gtetil/ME21000-Swoish-Grain-Control/Spec Sheets/chute control panel 9-5-2021.pdf

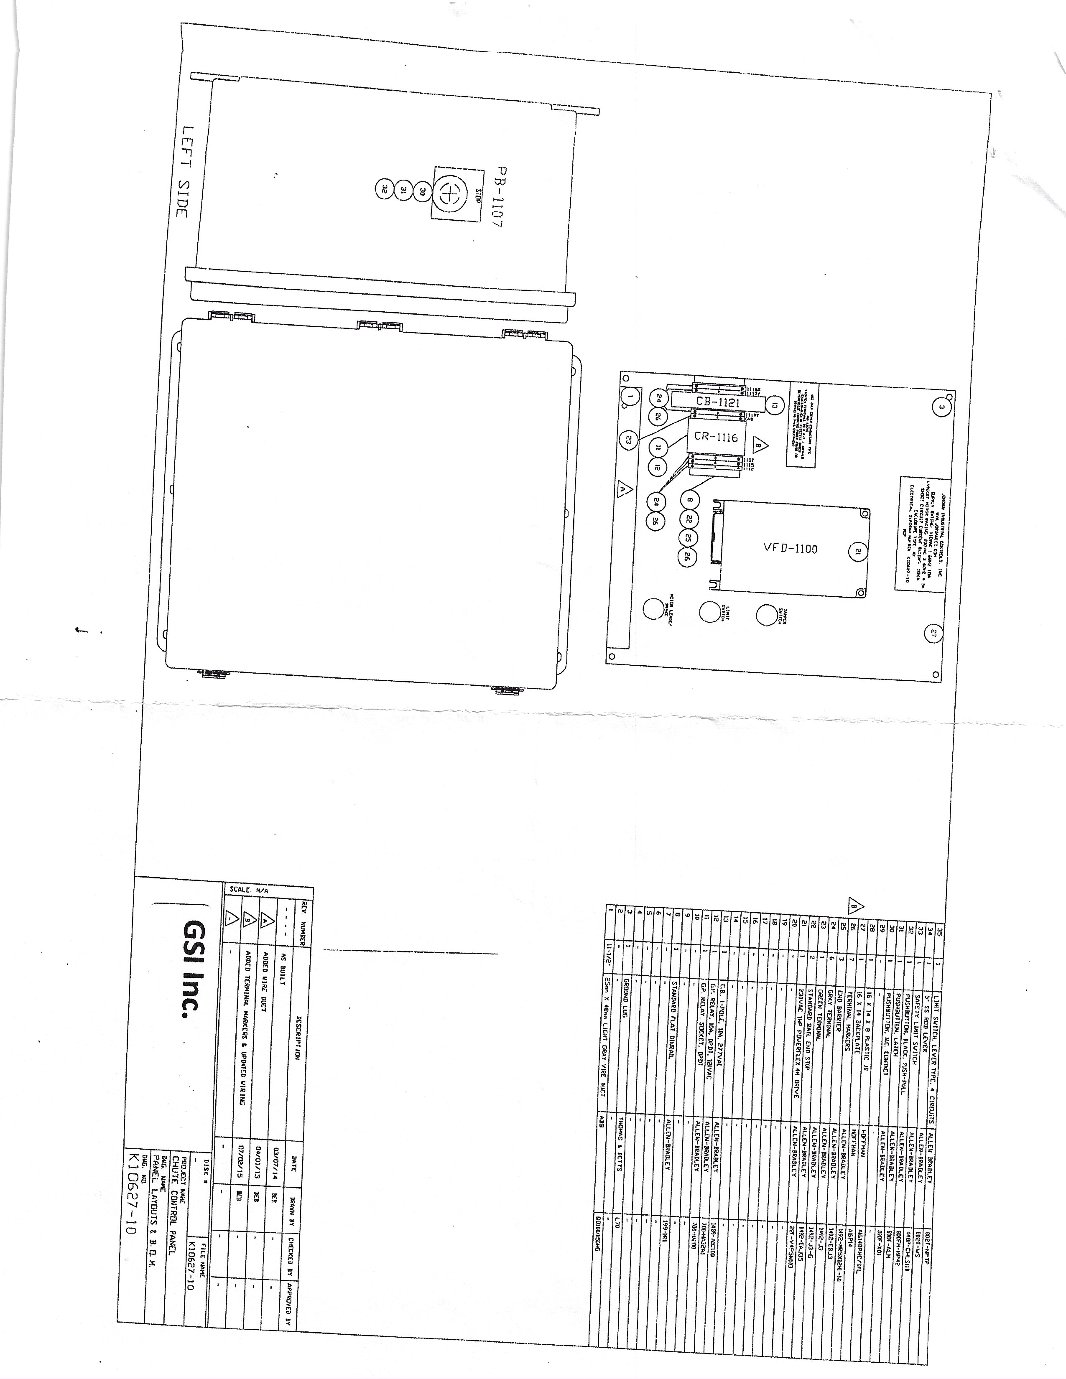
[picture p1: page 1]
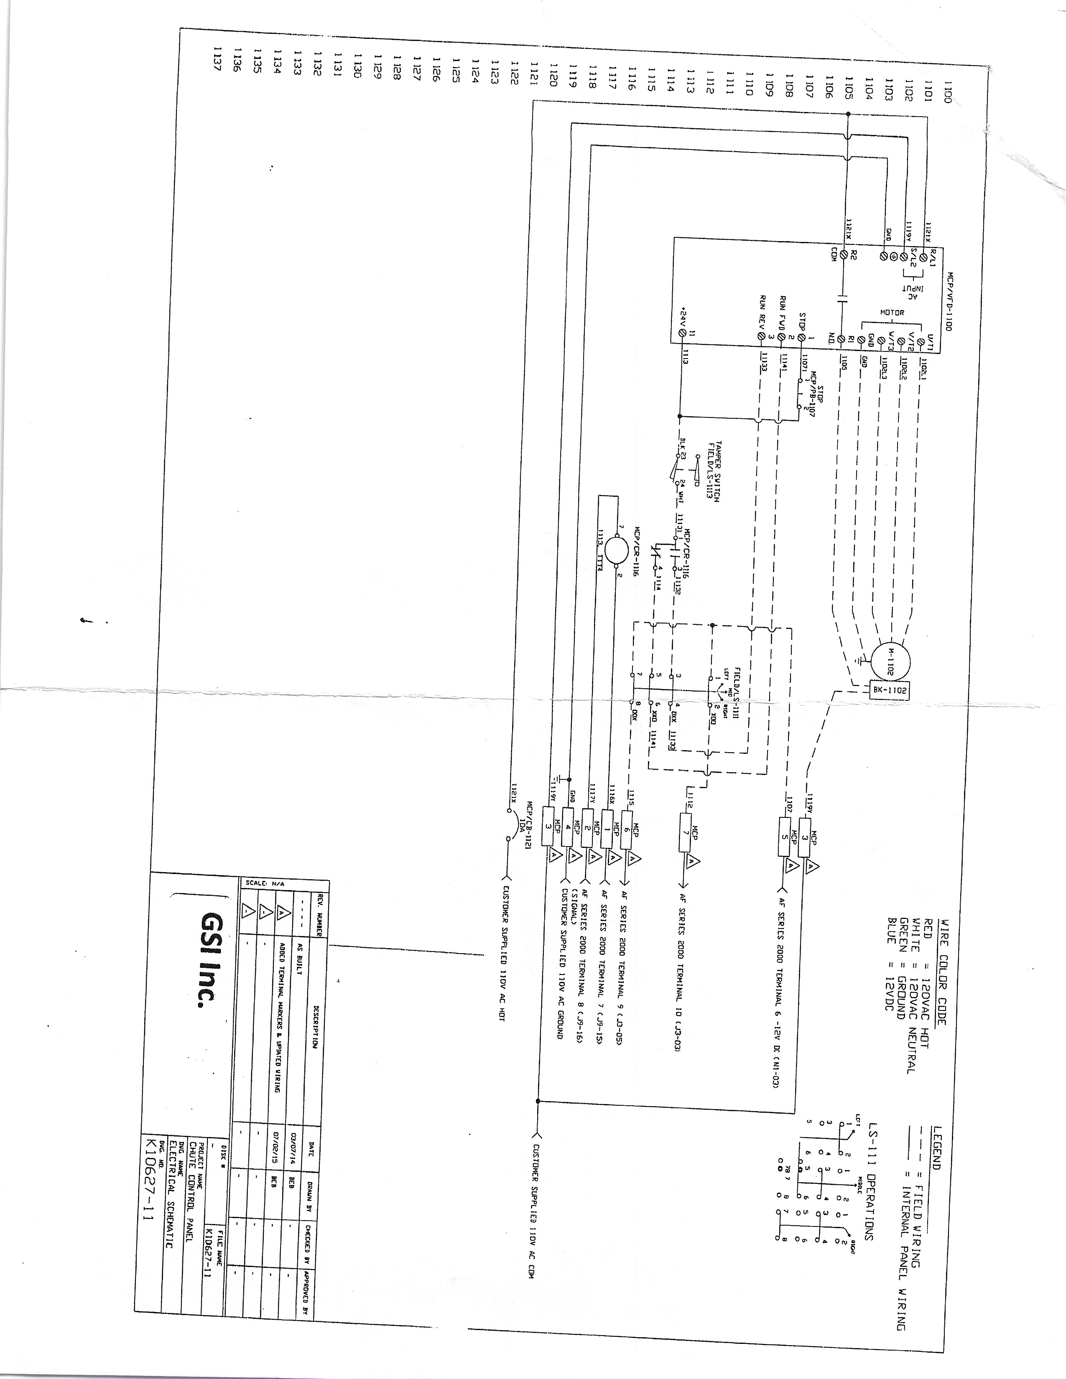
[picture p2: page 2]
