gtetil/ME21000-Swoish-Grain-Control/Electrical/ME21000E02-Model.png

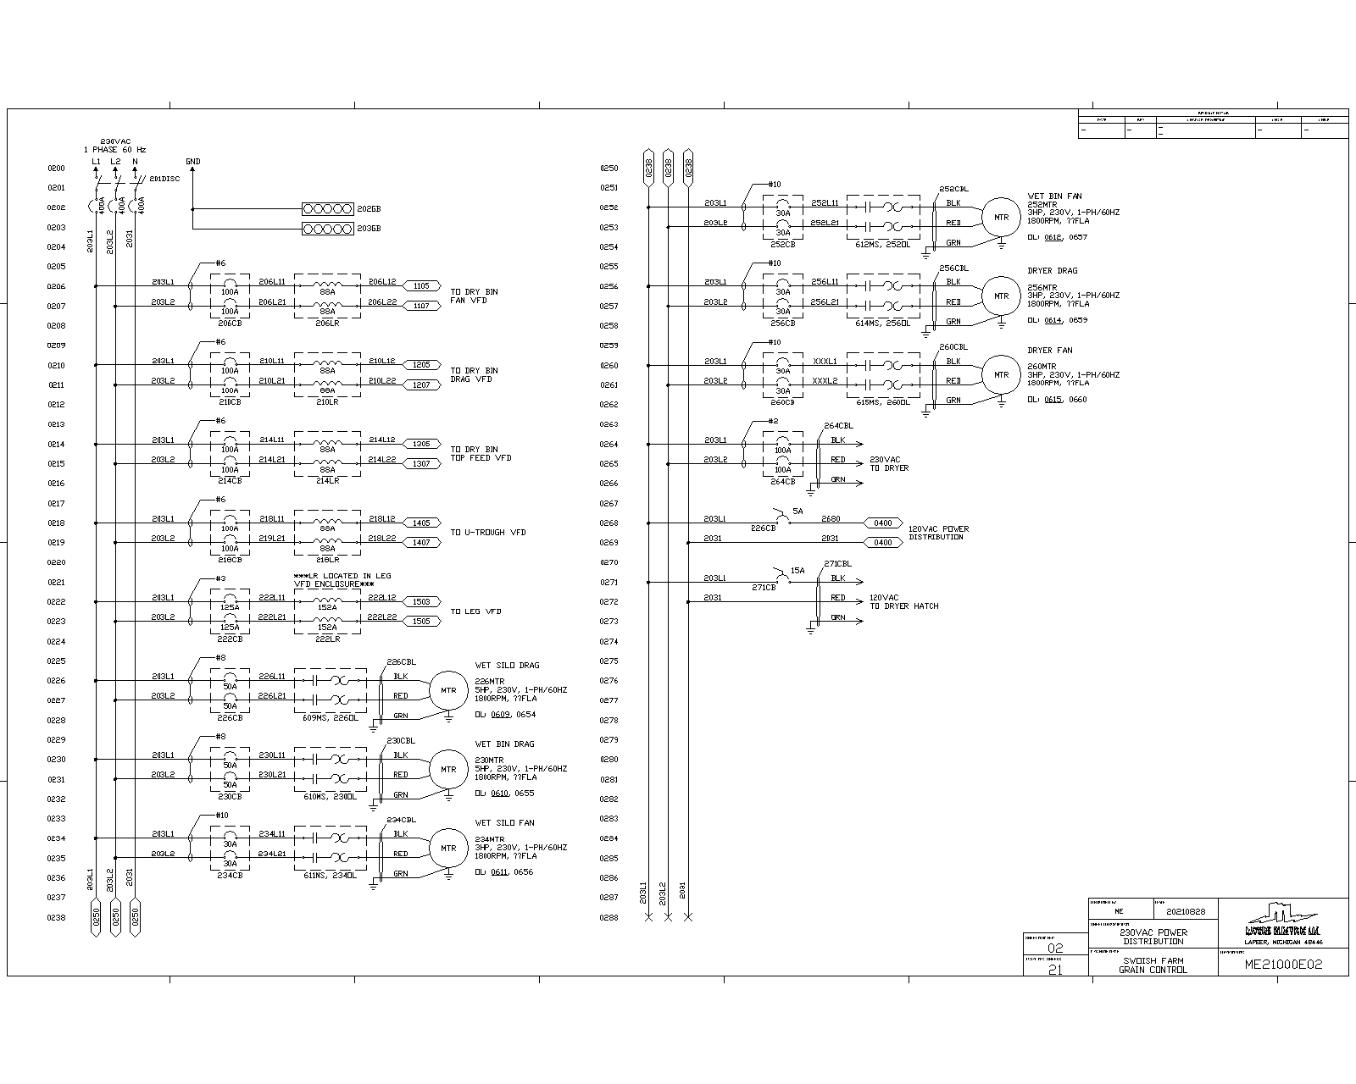
Electrical/ME21000E02-Model.png
