gtetil/ME21000-Swoish-Grain-Control/(list of files, cad)

Other CAD files:
LabVIEW/Layout/Grain Operation Layout.dwg
Electrical/ME21000E20.dwg
Electrical/ME21000E18.dwg
Electrical/ME21000E13.dwg
Electrical/ME21000E00.dwg
Electrical/ME21000E23.dwg
Electrical/ME21000E14.dwg
Electrical/ME21000E22.dwg
Electrical/ME21000E19.dwg
Electrical/ME21000E09.dwg
Electrical/ME21000E06.dwg
Electrical/ME21000E04.dwg
Electrical/ME21000E02.dwg
Electrical/ME21000E08.dwg
Electrical/ME21000E03.dwg
Electrical/ME21000E21.dwg
Electrical/ME21000E05.dwg
Electrical/ME21000E12.dwg
