gtetil/ME21000-Swoish-Grain-Control/Electrical/Swoish Grain Control BOM.pdf

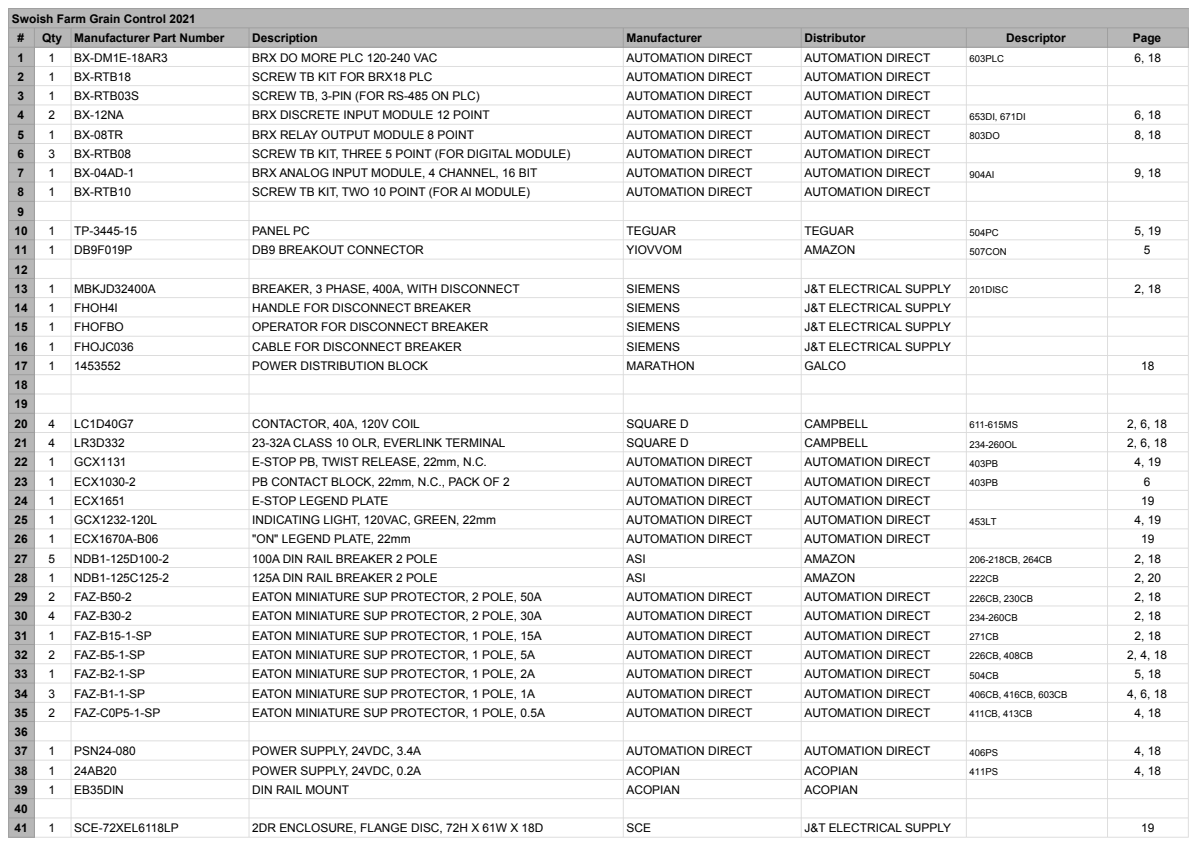
[picture p4: page 1]
Swoish Farm Grain Control 2021; Qty Manufacturer Part Number; Description; Manufacturer; Distributor; Descriptor; Page; BRX DO MORE PLC 120-240 VAC; AUTOMATION DIRECT; 603PLC; BX-RTB18; SCREW TB KIT FOR BRX18 PLC; BX-RTB03S; SCREW TB, 3-PIN (FOR RS-485 ON PLC); BRX DISCRETE INPUT MODULE 12 POINT; BRX RELAY OUTPUT MODULE 8 POINT; BX-RTB08; SCREW TB KIT, THREE 5 POINT (FOR DIGITAL MODULE); BRX ANALOG INPUT MODULE, 4 CHANNEL, 16 BIT; BX-RTB10; SCREW TB KIT, TWO 10 POINT (FOR AI MODULE); PANEL PC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

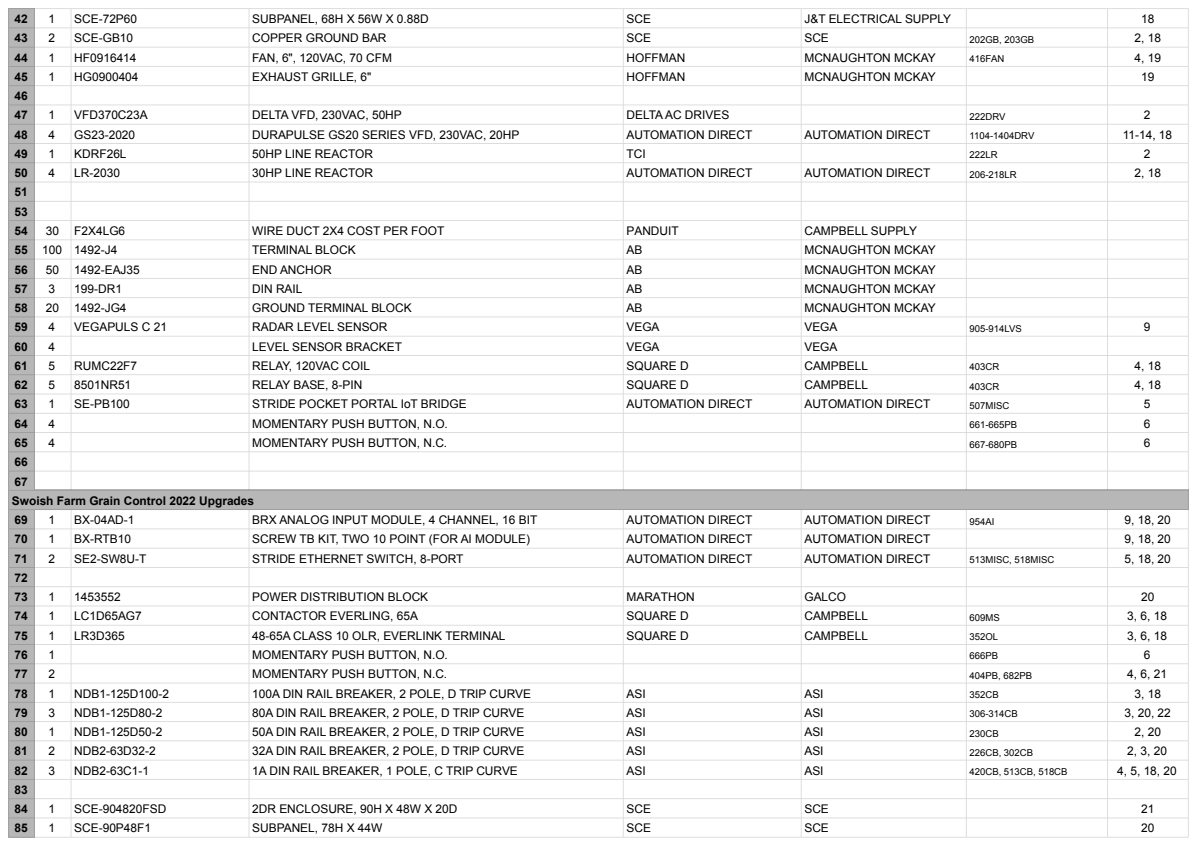
[picture p5: page 2]
SCE-72P60; SUBPANEL, 68H X 56W X 0.88D; SCE; J&T ELECTRICAL SUPPLY; SCE-GB10; COPPER GROUND BAR; FAN, 6", 120VAC, 70 CFM; HOFFMAN; MCNAUGHTON MCKAY; 416FAN; EXHAUST GRILLE, 6"; VFD370C23A; DELTA VFD, 230VAC, 50HP; DELTA AC DRIVES; 222DRV; DURAPULSE GS20 SERIES VFD, 230VAC, 20HP; AUTOMATION DIRECT; 1104-1404DRV; KDRF26L; 50HP LINE REACTOR; TCI; 30HP LINE REACTOR; WIRE DUCT 2X4 COST PER FOOT; PANDUIT; CAMPBELL SUPPLY; TERMINAL BLOCK; 1492-EAJ35; END ANCHOR; DIN RAIL; GROUND TERMINAL BLOCK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

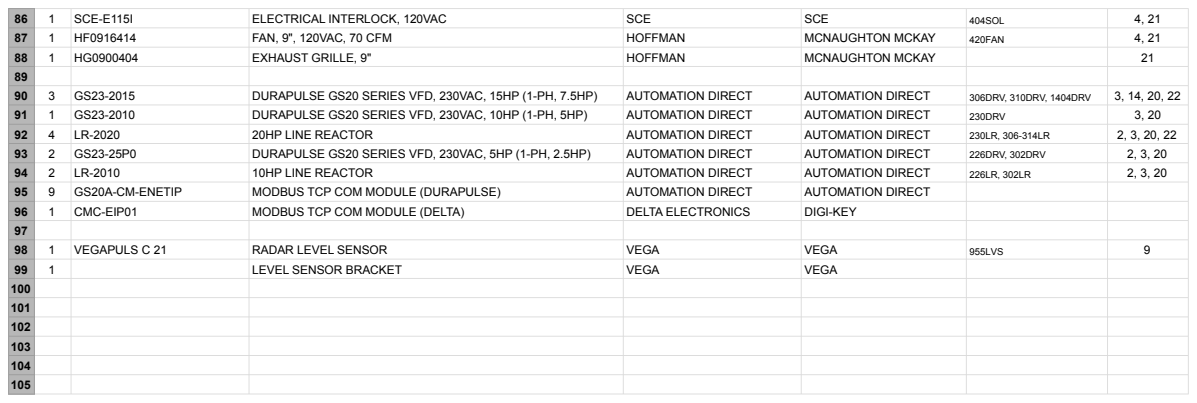
[picture p6: page 3]
SCE-E115I; ELECTRICAL INTERLOCK, 120VAC; SCE; 404SOL; FAN, 9", 120VAC, 70 CFM; HOFFMAN; MCNAUGHTON MCKAY; 420FAN; EXHAUST GRILLE, 9"; DURAPULSE GS20 SERIES VFD, 230VAC, 15HP (1-PH, 7.5HP); AUTOMATION DIRECT; 306DRV, 310DRV, 1404DRV; DURAPULSE GS20 SERIES VFD, 230VAC, 10HP (1-PH, 5HP); 230DRV; 20HP LINE REACTOR; DURAPULSE GS20 SERIES VFD, 230VAC, 5HP (1-PH, 2.5HP); 226DRV, 302DRV; 10HP LINE REACTOR; GS20A-CM-ENETIP; MODBUS TCP COM MODULE (DURAPULSE); CMC-EIP01; MODBUS TCP COM MODULE (DELTA)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
