gtetil/ME21000-Swoish-Grain-Control/Electrical/Swoish Grain Control BOM (2021).pdf

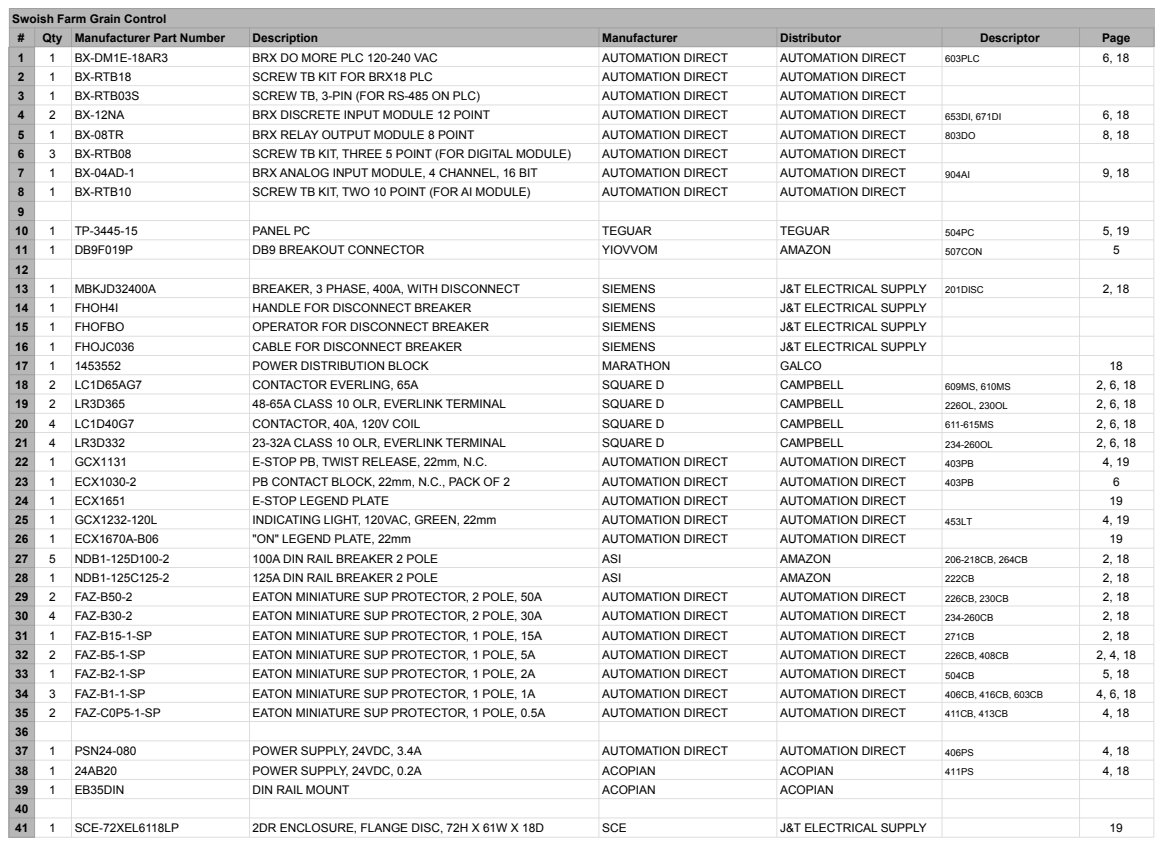
[picture p7: page 1]
Swoish Farm Grain Control; Qty; Manufacturer Part Number; Description; Manufacturer; Distributor; Descriptor; Page; BRX DO MORE PLC 120-240 VAC; AUTOMATION DIRECT; 603PLC; BX-RTB18; SCREW TB KIT FOR BRX18 PLC; BX-RTB03S; SCREW TB, 3-PIN (FOR RS-485 ON PLC); BRX DISCRETE INPUT MODULE 12 POINT; BRX RELAY OUTPUT MODULE 8 POINT; BX-RTB08; SCREW TB KIT, THREE 5 POINT (FOR DIGITAL MODULE); BRX ANALOG INPUT MODULE, 4 CHANNEL, 16 BIT; BX-RTB10; SCREW TB KIT, TWO 10 POINT (FOR AI MODULE); PANEL PC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

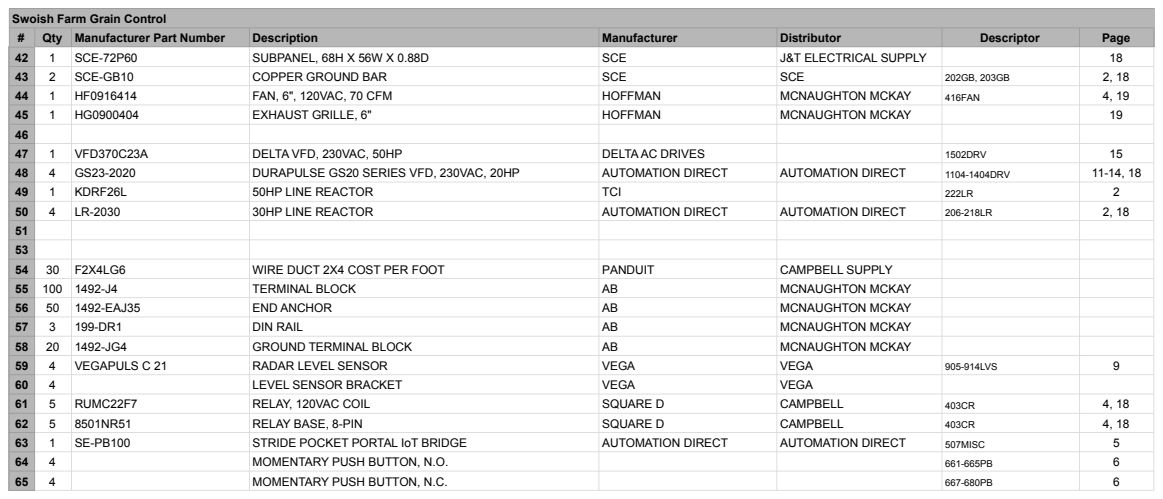
[picture p8: page 2]
Swoish Farm Grain Control; Qty; Manufacturer Part Number; Description; Manufacturer; Distributor; Descriptor; Page; SCE-72P60; SUBPANEL, 68H X 56W X 0.88D; SCE; J&T ELECTRICAL SUPPLY; SCE-GB10; COPPER GROUND BAR; FAN, 6", 120VAC, 70 CFM; HOFFMAN; MCNAUGHTON MCKAY; 416FAN; EXHAUST GRILLE, 6"; VFD370C23A; DELTA VFD, 230VAC, 50HP; DELTA AC DRIVES; 1502DRV; DURAPULSE GS20 SERIES VFD, 230VAC, 20HP; AUTOMATION DIRECT; 1104-1404DRV; KDRF26L; 50HP LINE REACTOR; TCI; 30HP LINE REACTOR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
