gtetil/ME21000-Swoish-Grain-Control/Electrical/ME21000 Swoish Grain Control.pdf

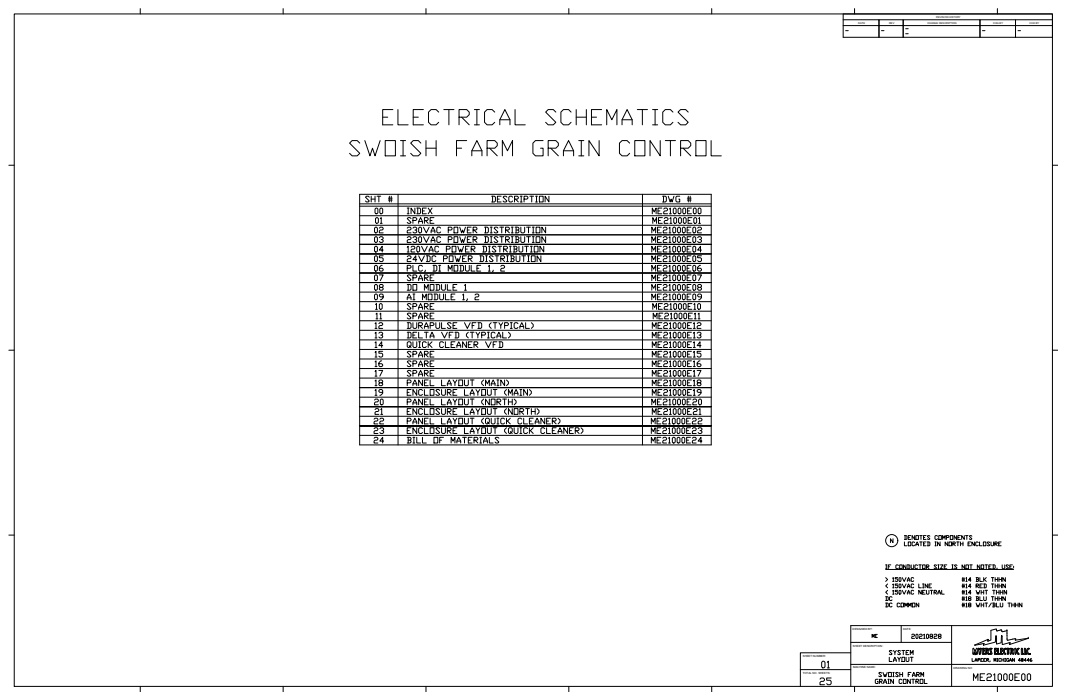
[picture p9: page 1]
MACHINE NAME:; DRAWING NO: DESIGNED BY: SHEET NUMBER: TOTAL NO. SHEETS:; SHEET DESCRIPTION:; DATE:; REVISION HISTORY DATE; REV; CHANGE DESCRIPTION; CHG BY; CHK BY

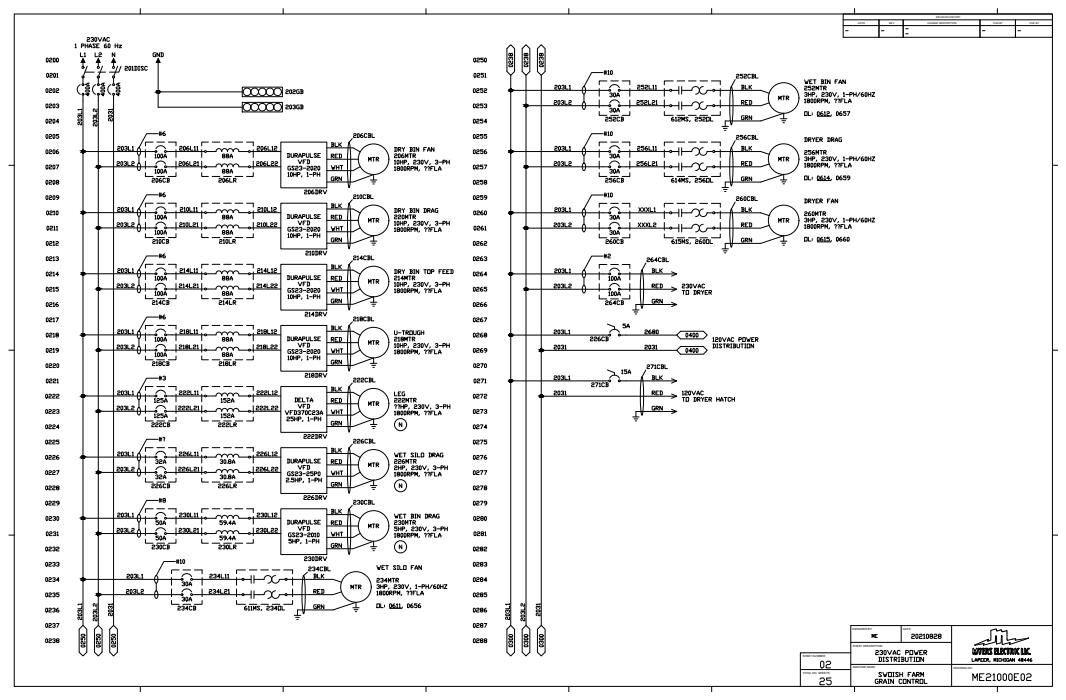
[picture p10: page 2]
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

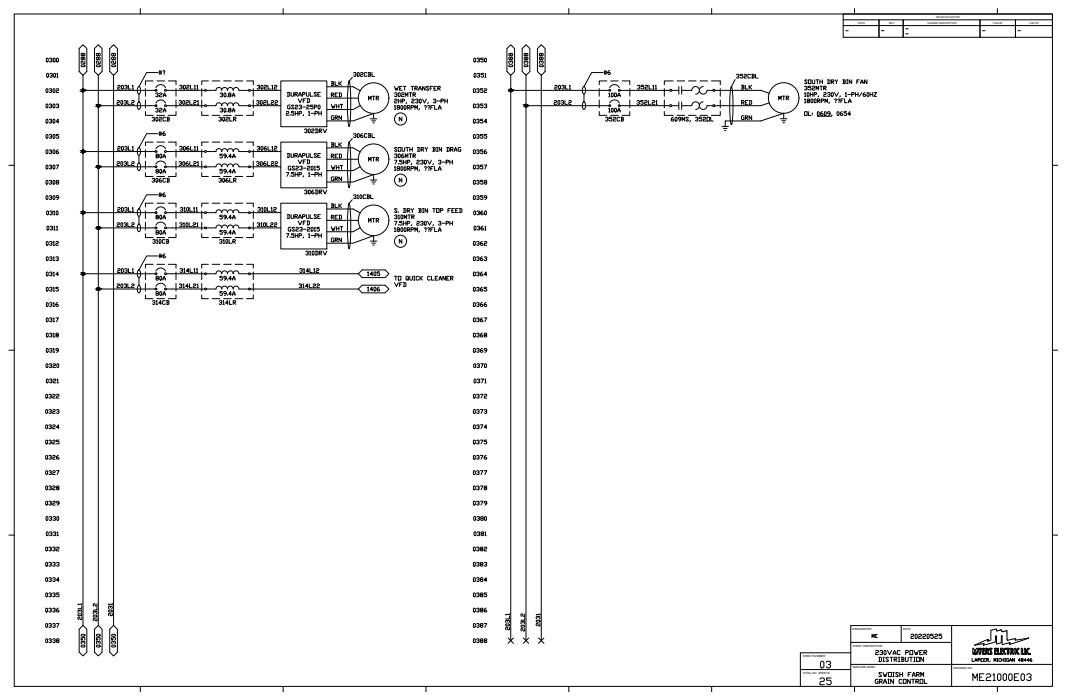
[picture p11: page 3]
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

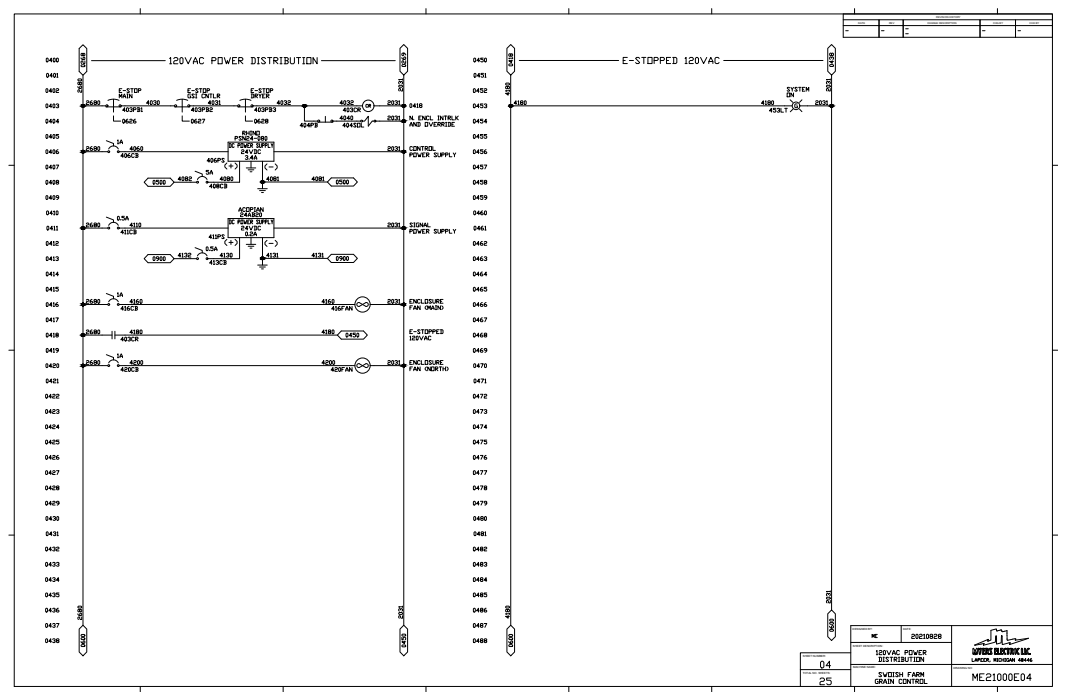
[picture p12: page 4]
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

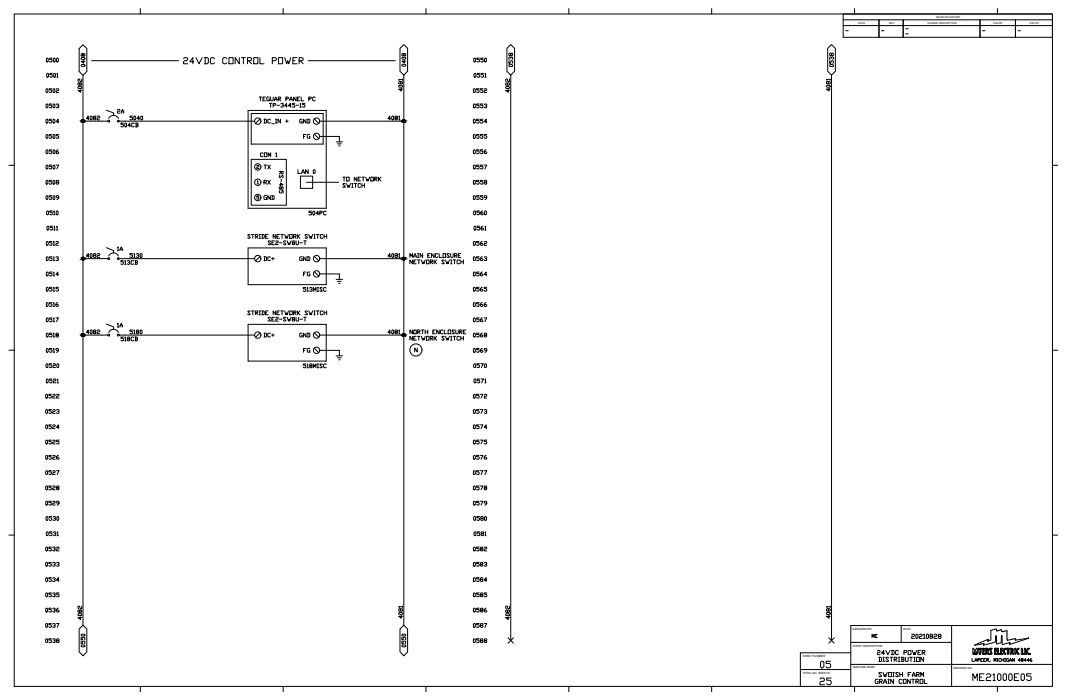
[picture p13: page 5]
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

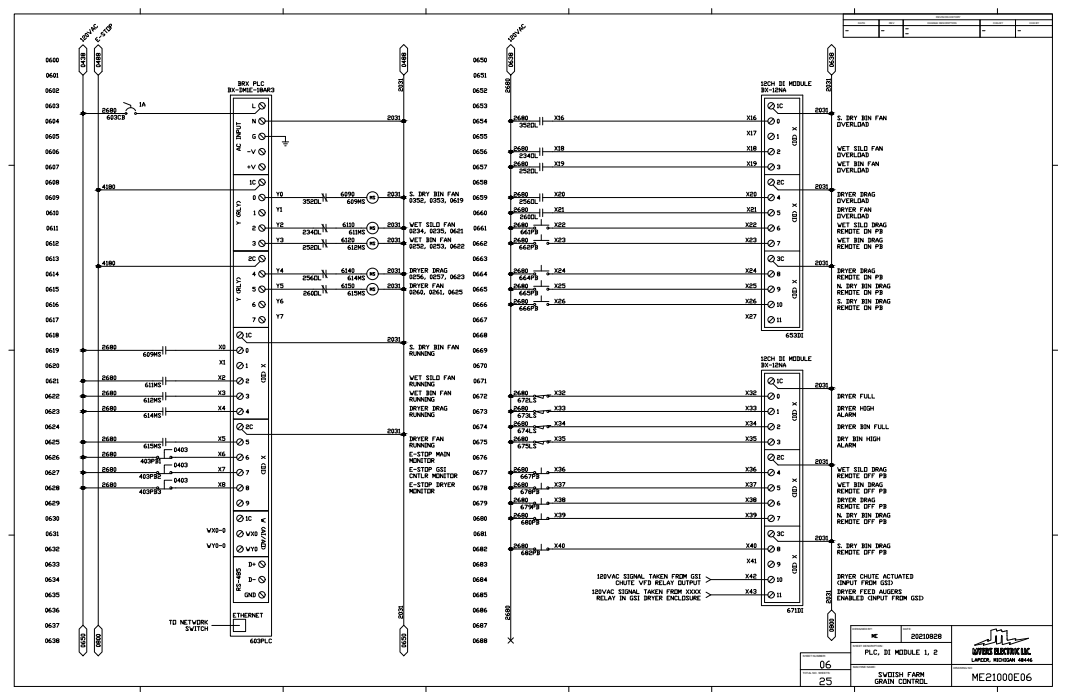
[picture p14: page 6]
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

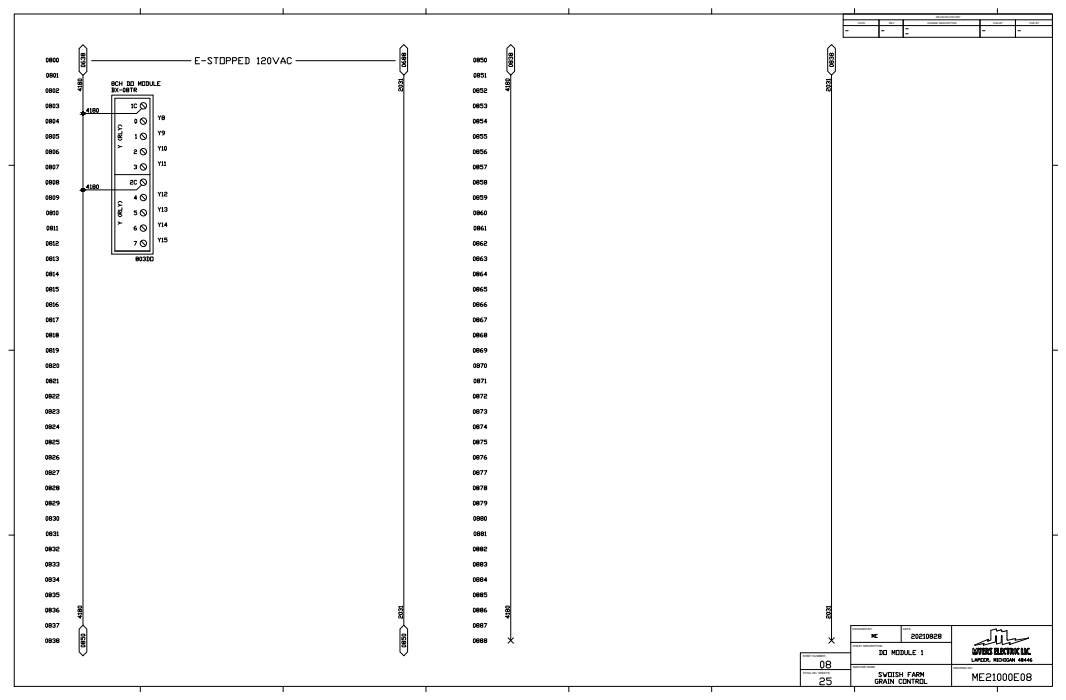
[picture p15: page 7]
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

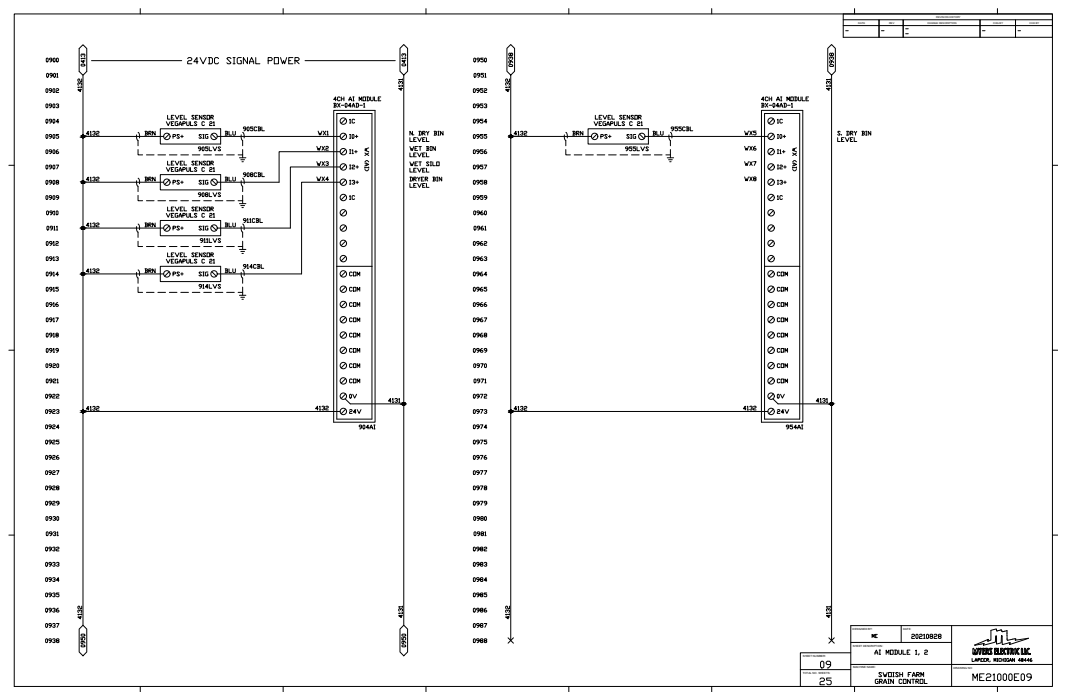
[picture p16: page 8]
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

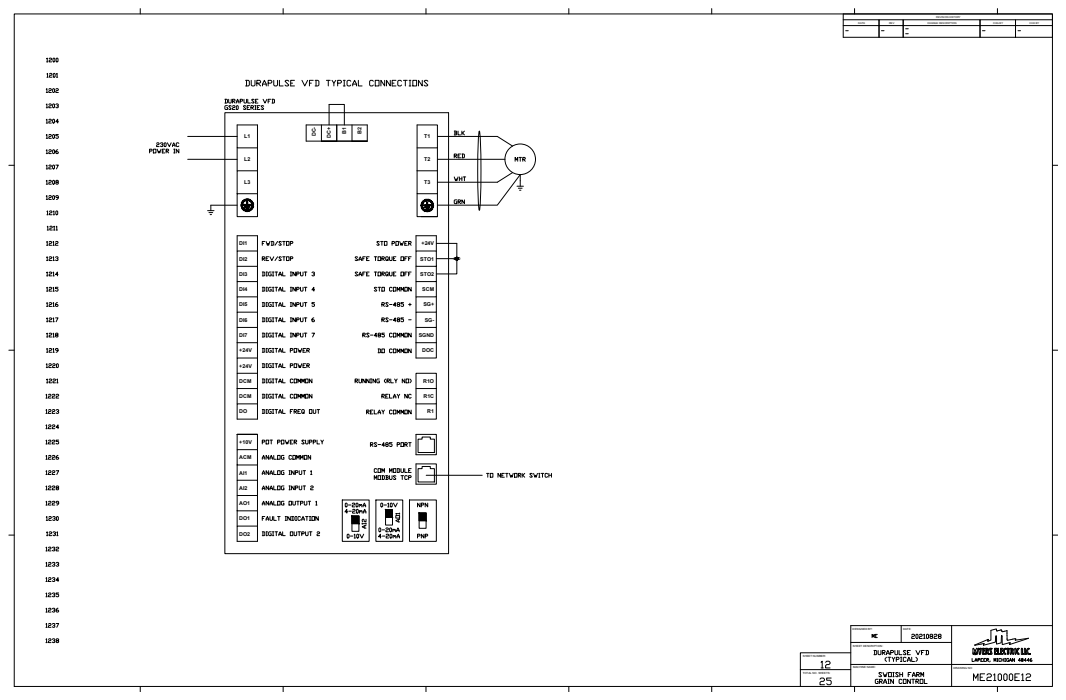
[picture p17: page 9]
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

DC+B1 B2 +24V +24V DI1 DI2 DI3 DI4 DI5 DI6 DI7 DCM DODCM AI1 AI2 +10V ACM DO1 DO2 AO1 +24V STO1 STO2 SCM SG+ SG- SGND DOC R1O R1CR1 T1T2T3

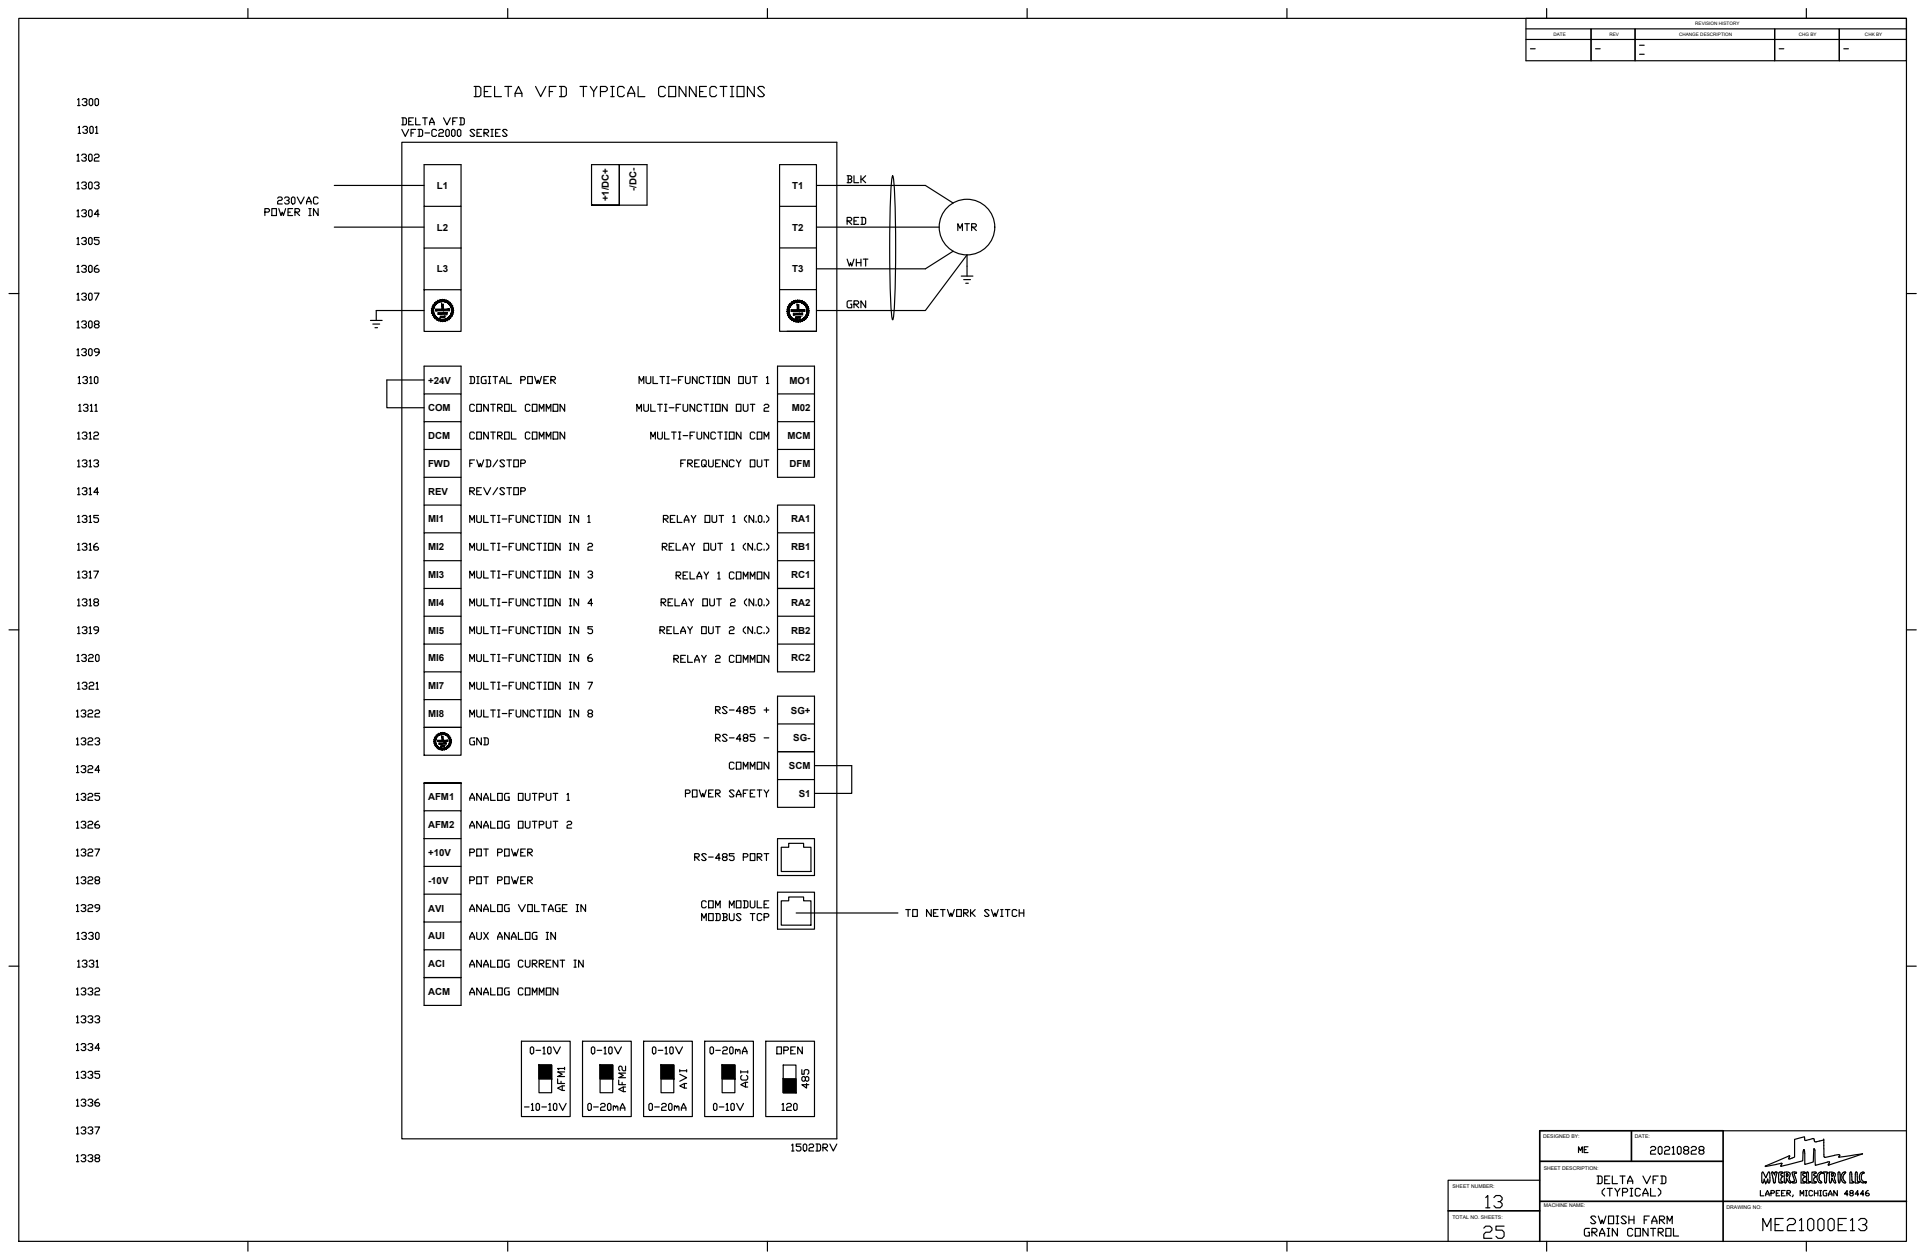
[picture p18: page 10]
MACHINE NAME:; DRAWING NO: DESIGNED BY: SHEET NUMBER: TOTAL NO. SHEETS:; SHEET DESCRIPTION:; DATE:; REVISION HISTORY DATE; REV; CHANGE DESCRIPTION; CHG BY; CHK BY L1L2L3

-/DC- MI3 MI4 +24V COM DCM FWD REV MI1 MI2 MI6 MI7 MI5 +10V -10V AFM1 AFM2 AUI ACI AVI MO1 M02 MCM DFM RA1 RB1 RC1 T1T2T3 ACM SG+ SG- RA2 RB2 RC2 SCMS1 MI8

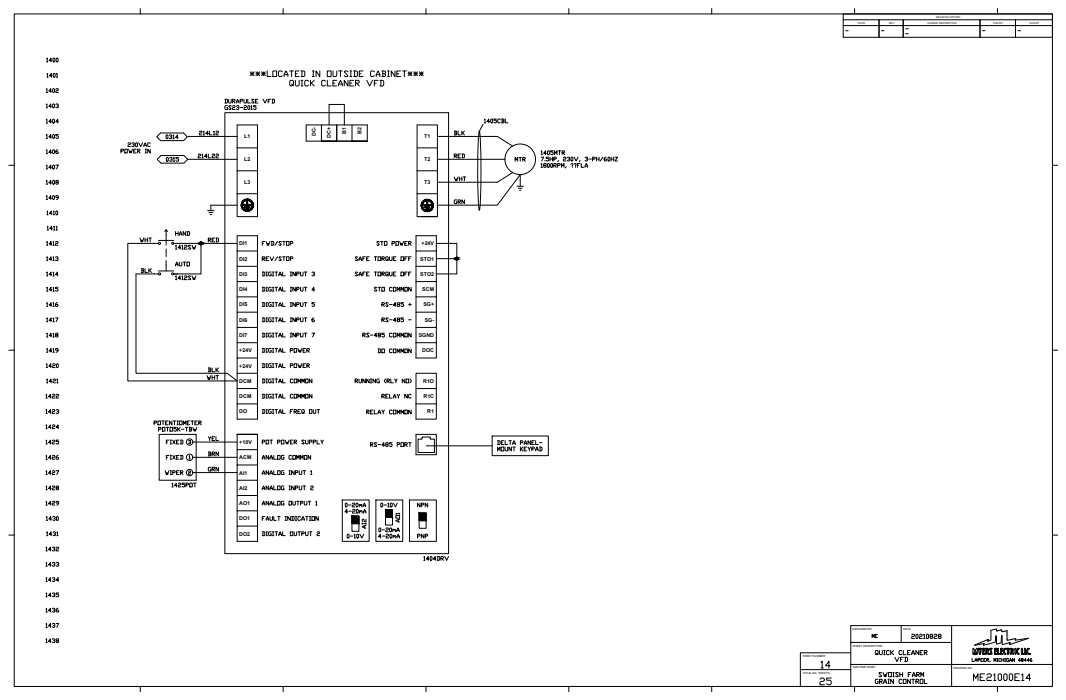
[picture p19: page 11]
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

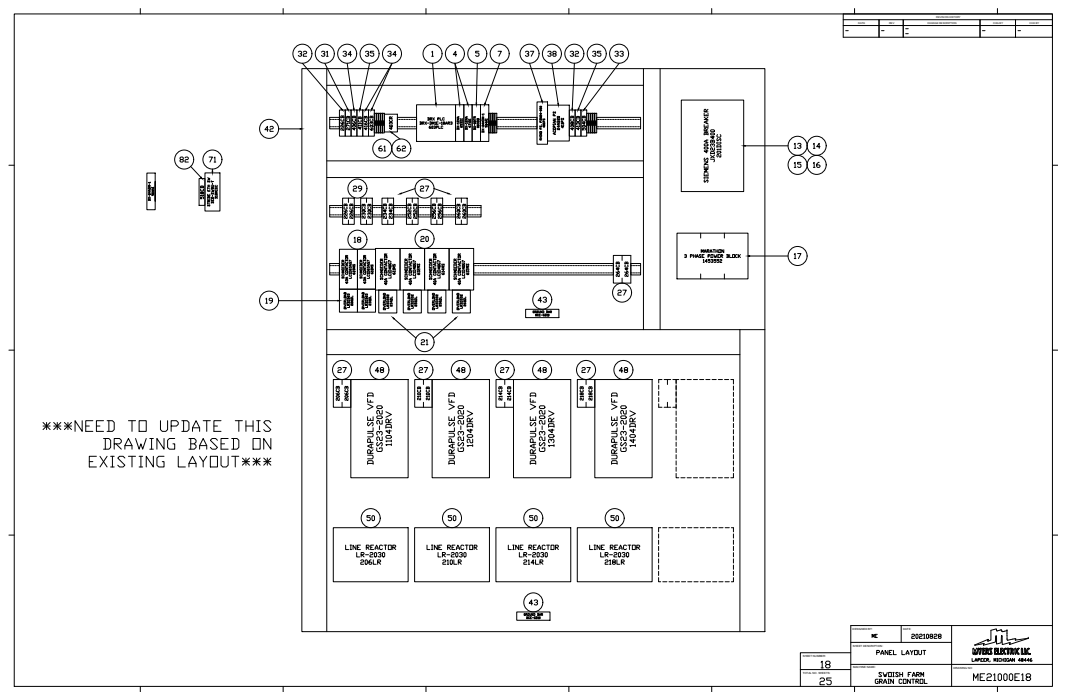
[picture p20: page 12]
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

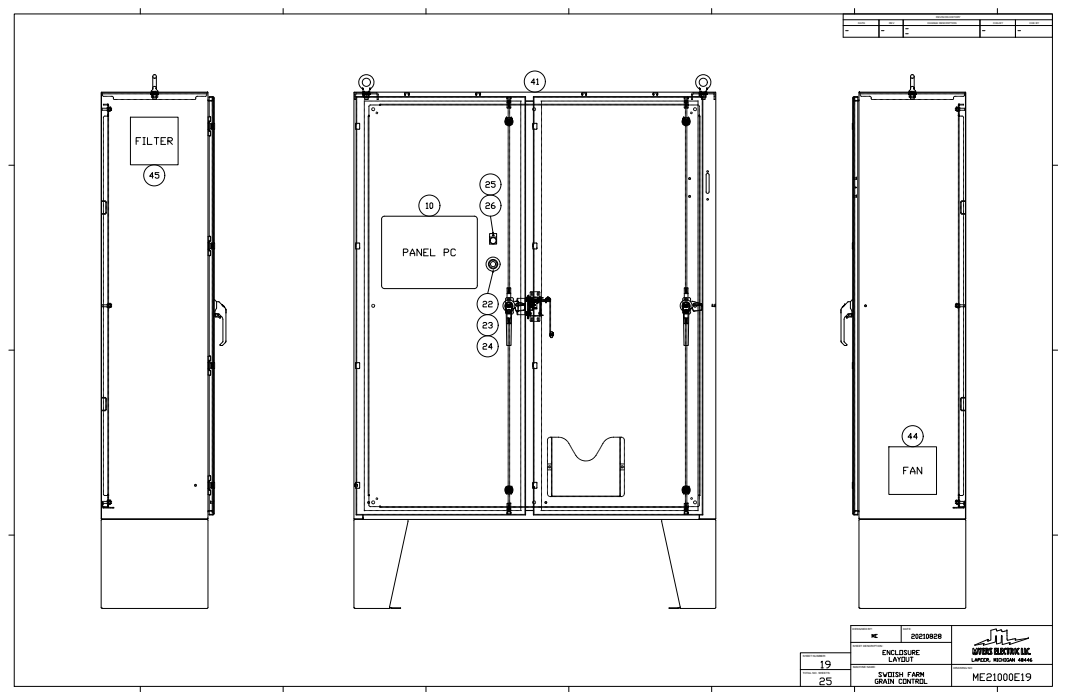
[picture p21: page 13]
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

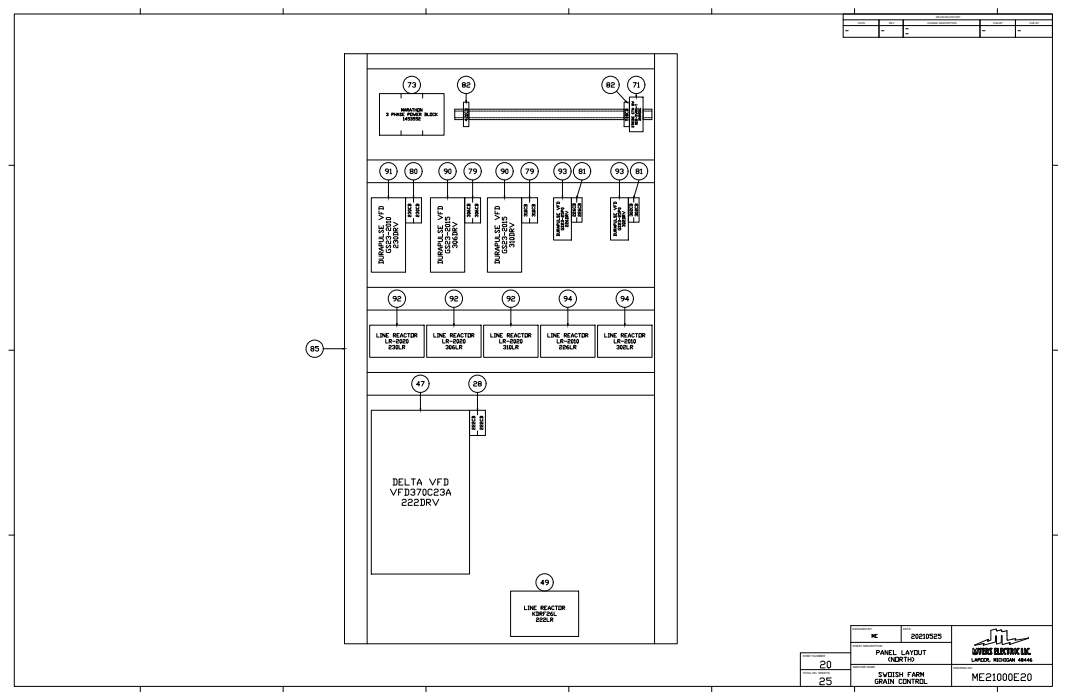
[picture p22: page 14]
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

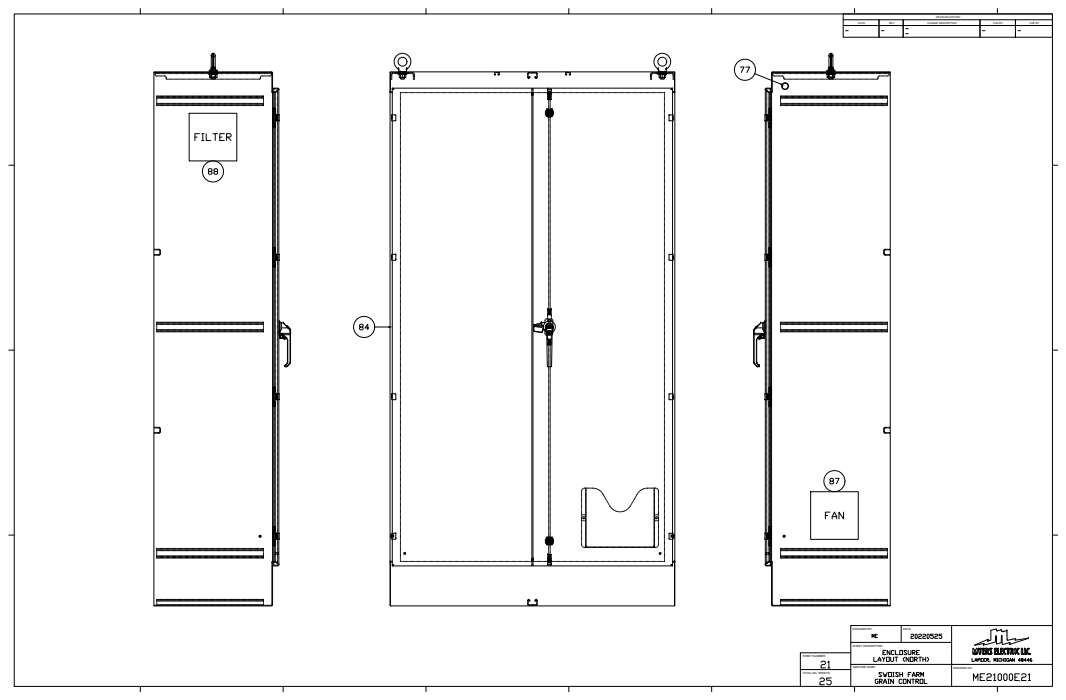
[picture p23: page 15]
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

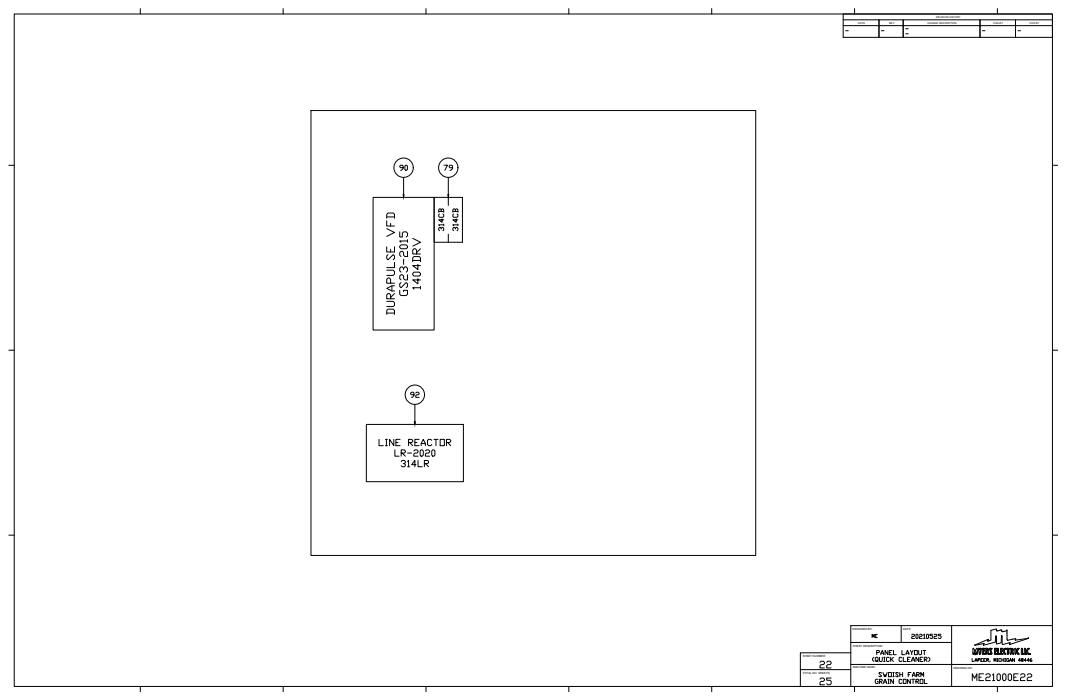
[picture p24: page 16]
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

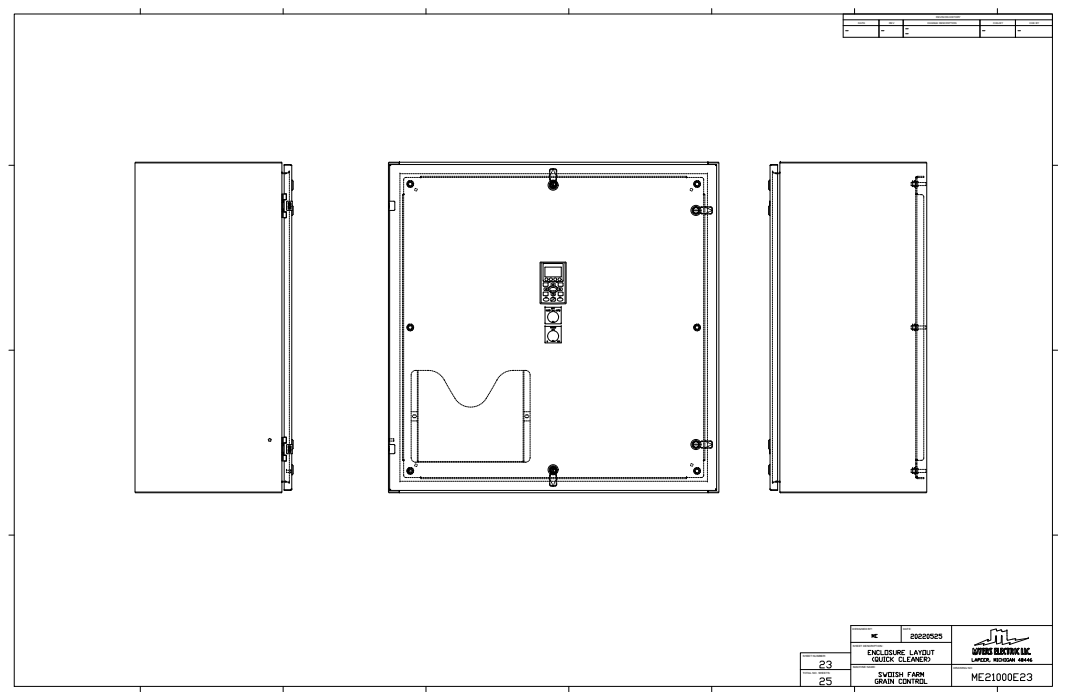
[picture p25: page 17]
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
