gtetil/ME21000-Swoish-Grain-Control/Electrical/ME21000 Swoish Grain Control (2021).pdf

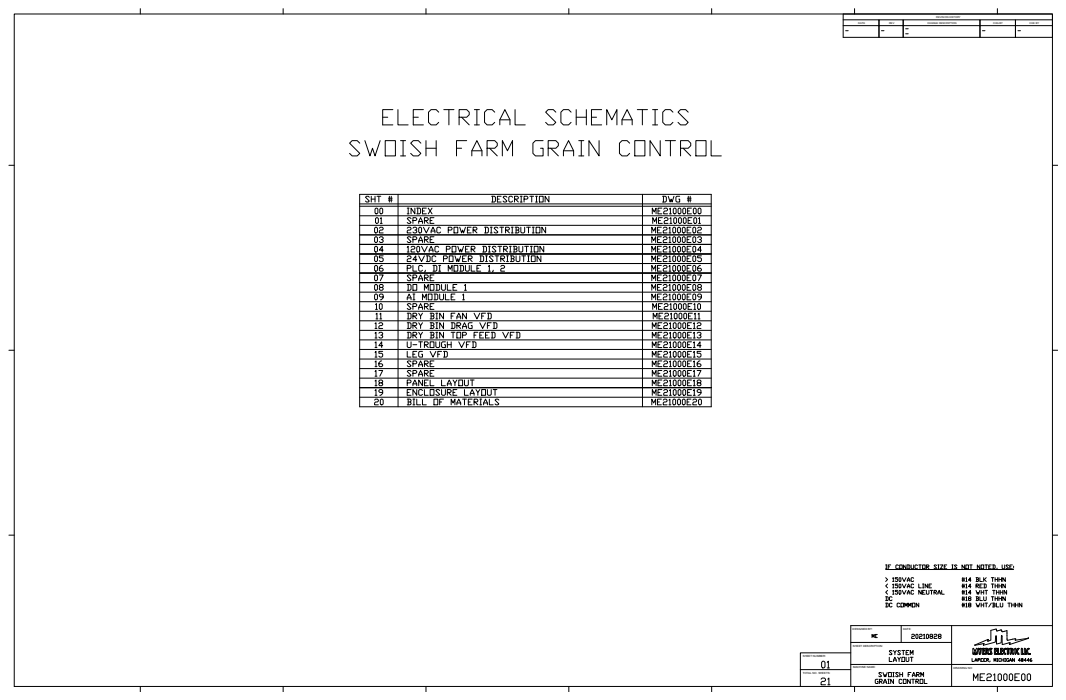
[picture p26: page 1]
MACHINE NAME:; DRAWING NO: DESIGNED BY: SHEET NUMBER: TOTAL NO. SHEETS:; SHEET DESCRIPTION:; DATE:; REVISION HISTORY DATE; REV; CHANGE DESCRIPTION; CHG BY; CHK BY

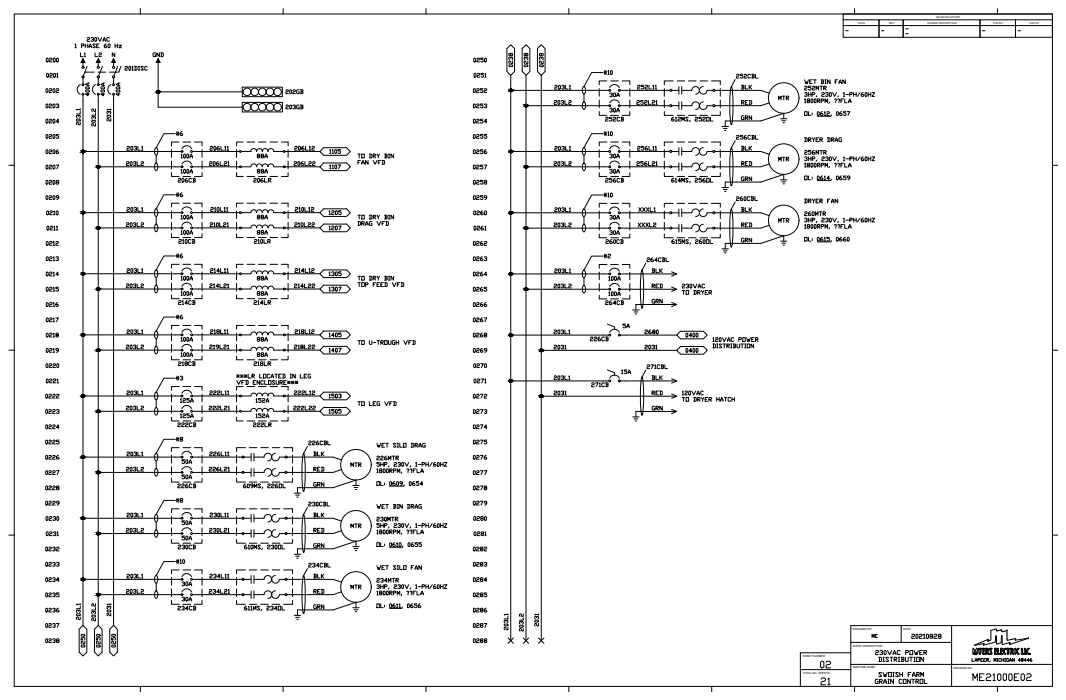
[picture p27: page 2]
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

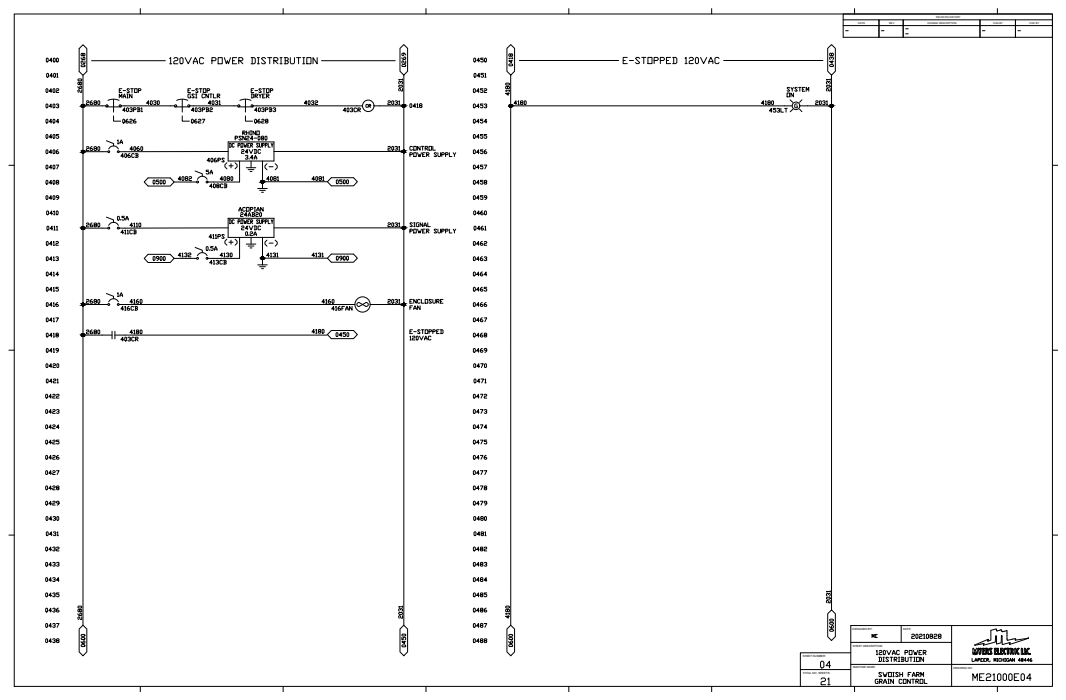
[picture p28: page 3]
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

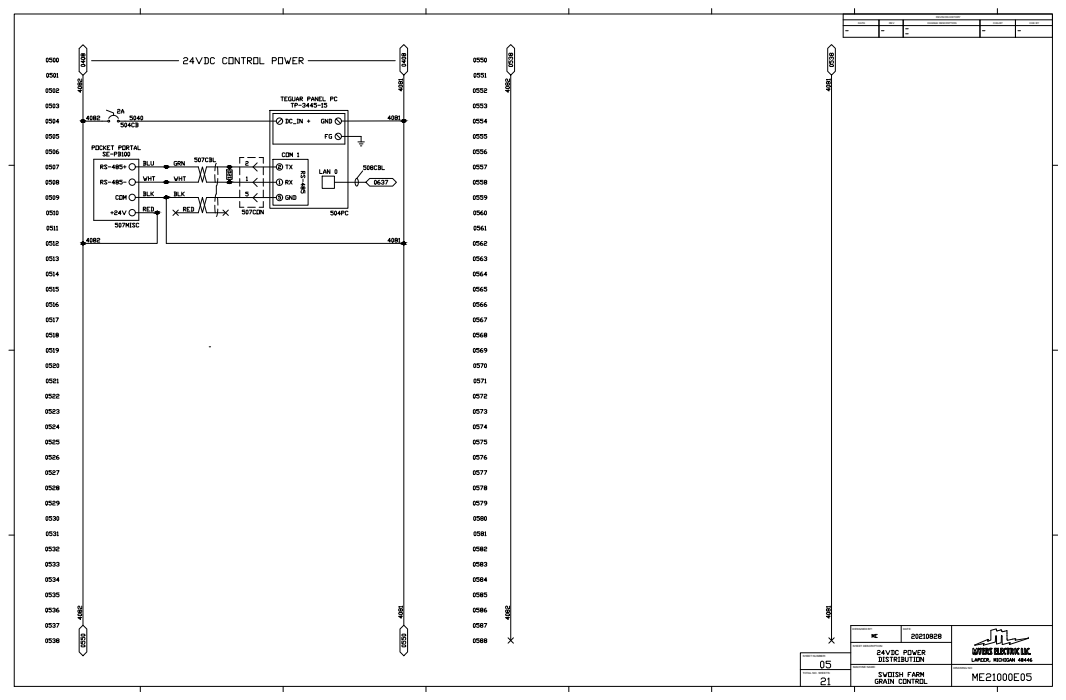
[picture p29: page 4]
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

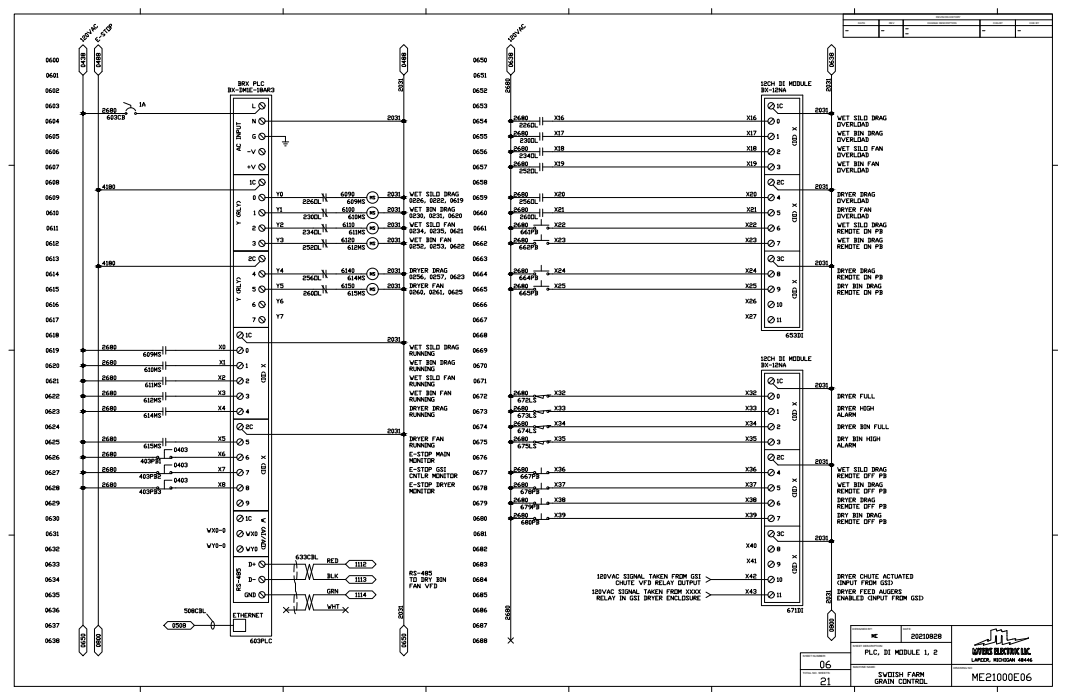
[picture p30: page 5]
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

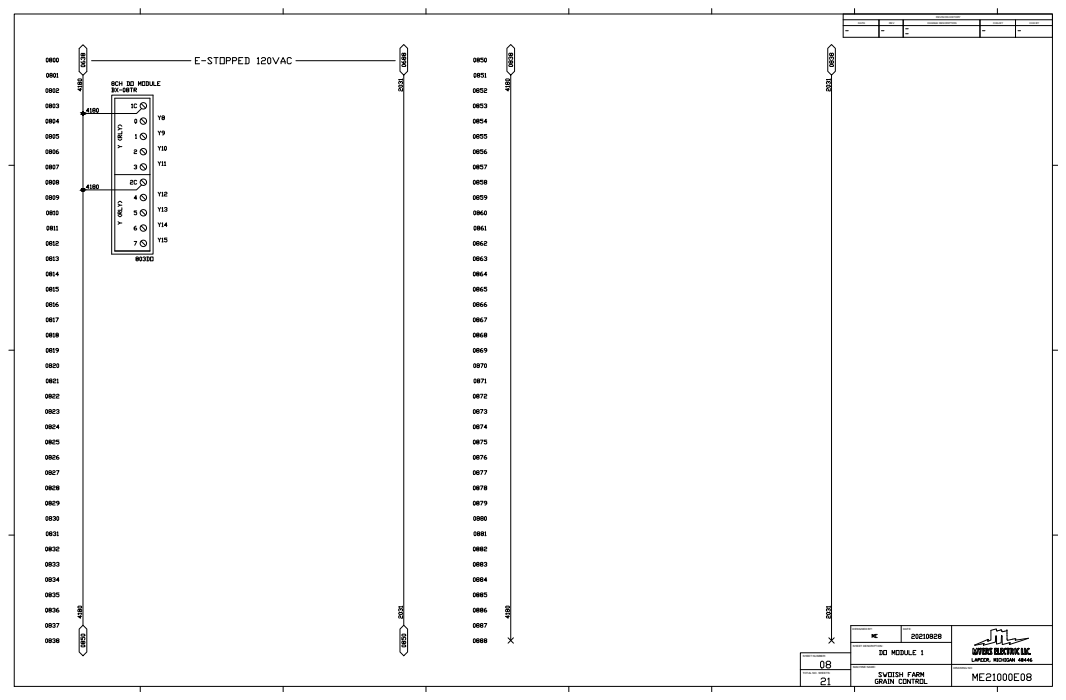
[picture p31: page 6]
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

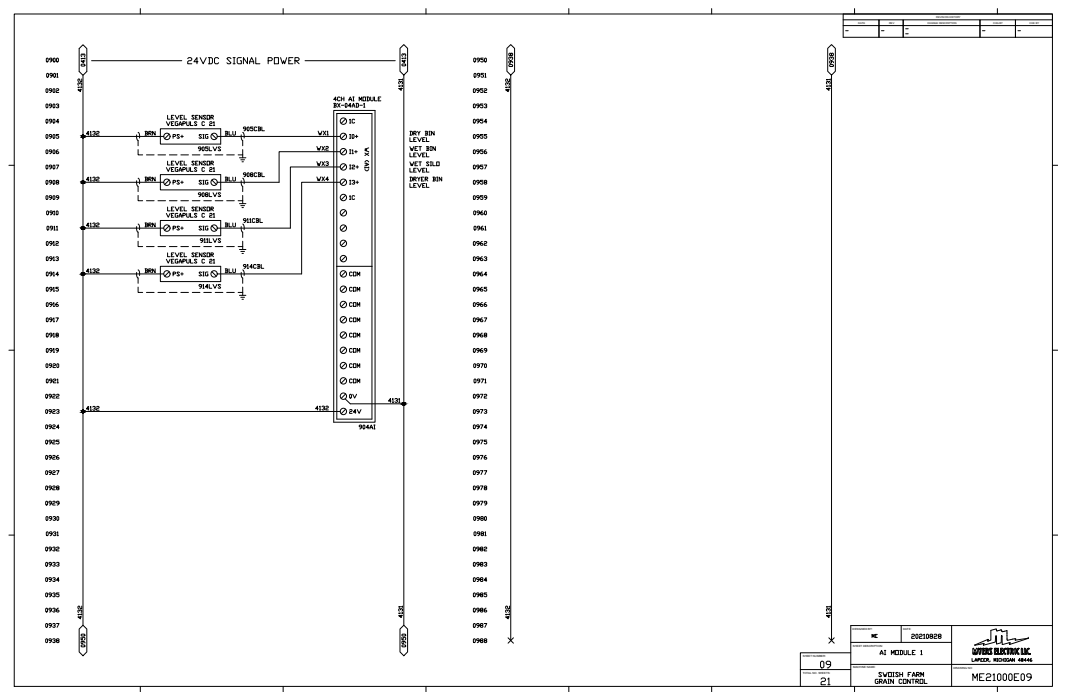
[picture p32: page 7]
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

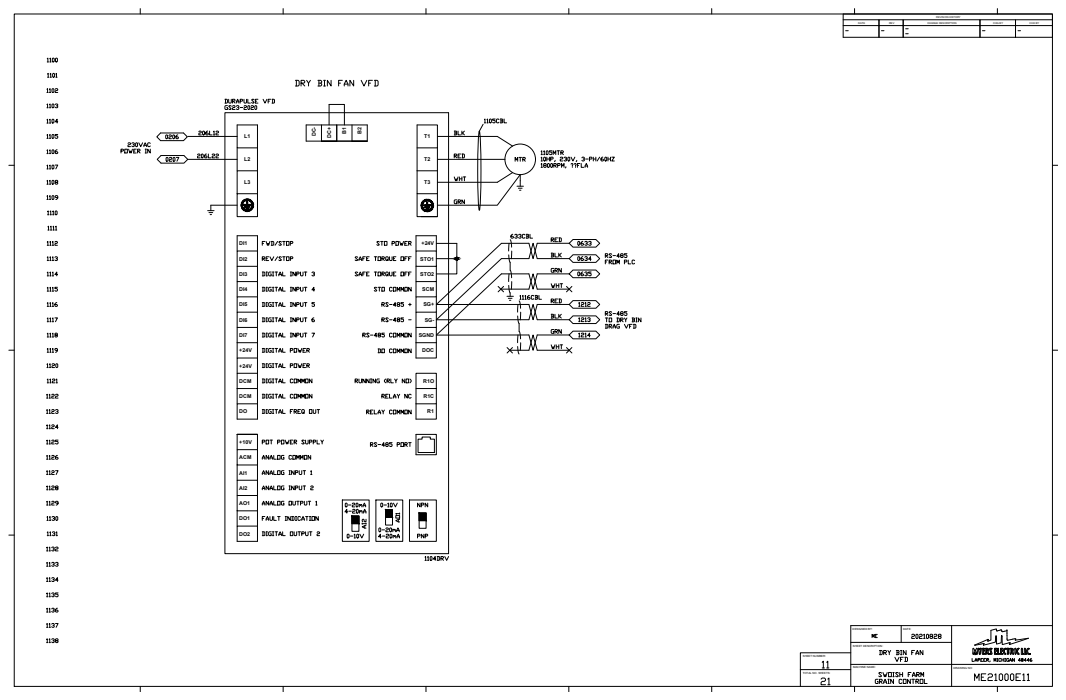
[picture p33: page 8]
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

DC+B1 B2 +24V +24V DI1 DI2 DI3 DI4 DI5 DI6 DI7 DCM DODCM AI1 AI2 +10V ACM DO1 DO2 AO1 +24V STO1 STO2 SCM SG+ SG- SGND DOC R1O R1CR1 T1T2T3

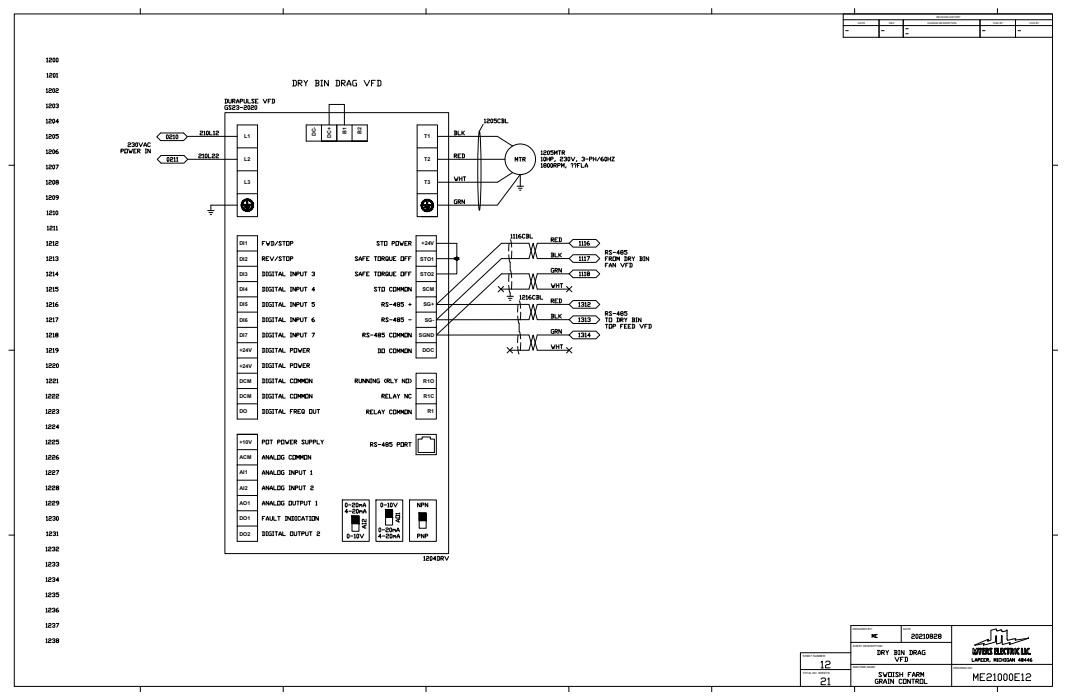
[picture p34: page 9]
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

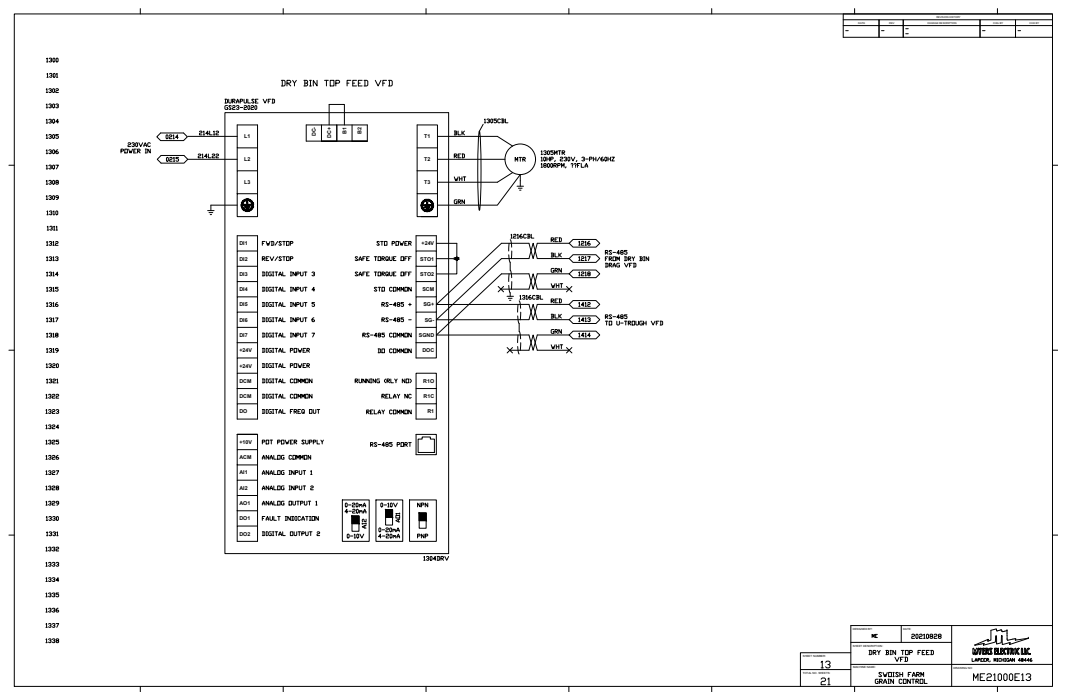
[picture p35: page 10]
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

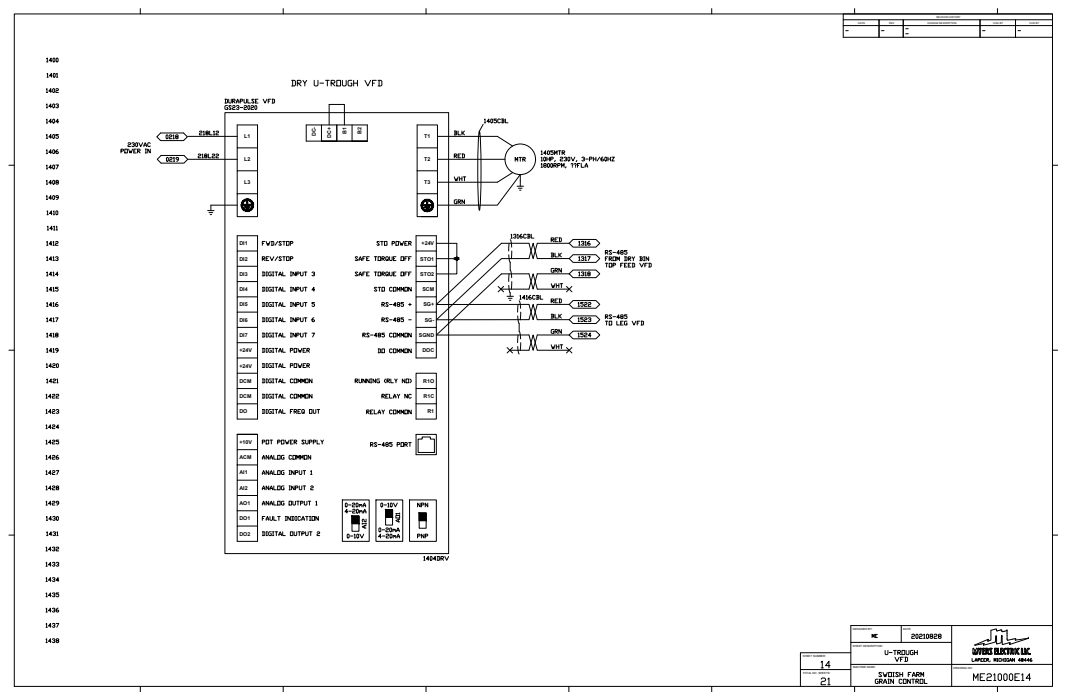
[picture p36: page 11]
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

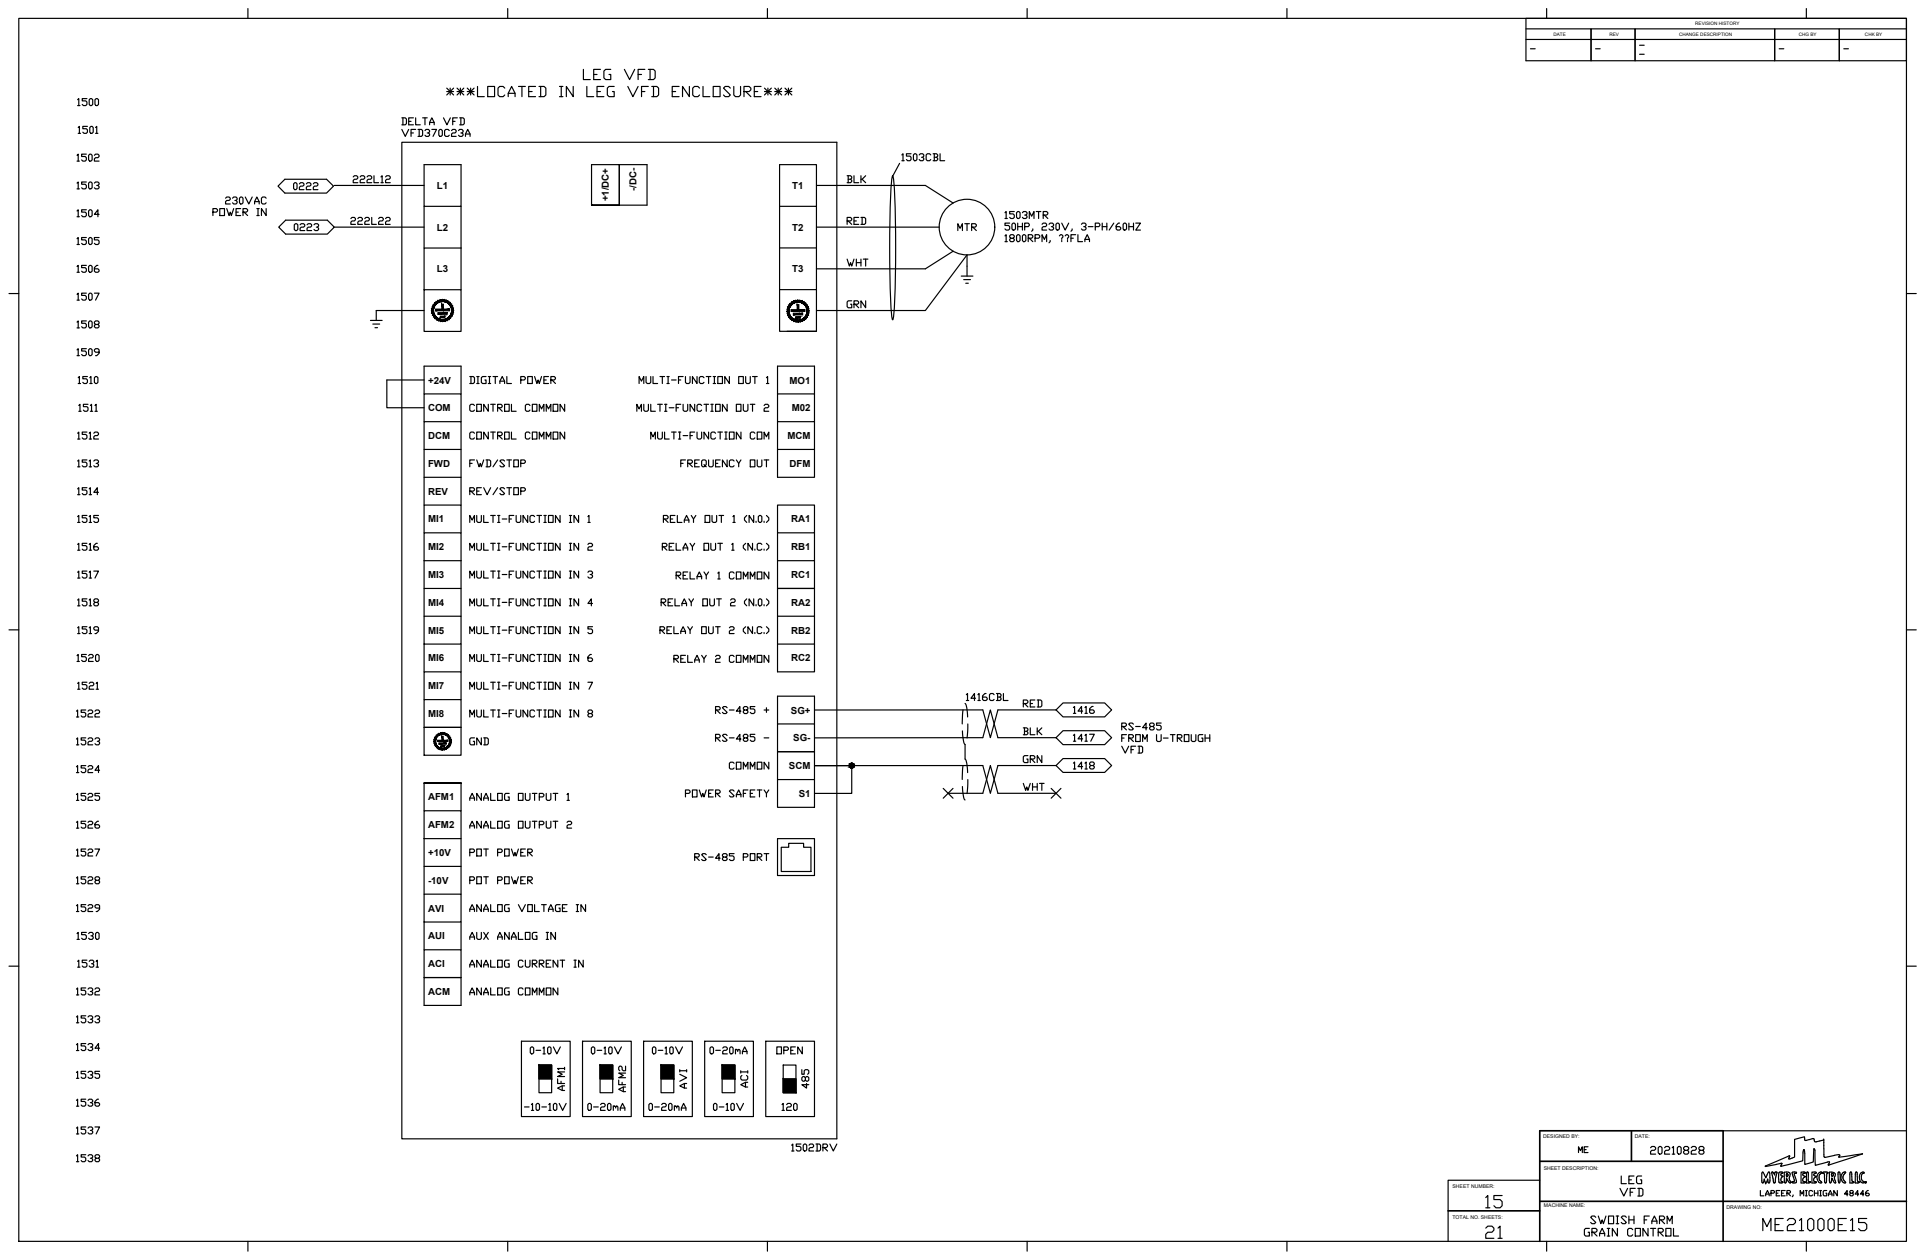
[picture p37: page 12]
MACHINE NAME:; DRAWING NO: DESIGNED BY: SHEET NUMBER: TOTAL NO. SHEETS:; SHEET DESCRIPTION:; DATE:; REVISION HISTORY DATE; REV; CHANGE DESCRIPTION; CHG BY; CHK BY L1L2L3

-/DC- MI3 MI4 +24V COM DCM FWD REV MI1 MI2 MI6 MI7 MI5 +10V -10V AFM1 AFM2 AUI ACI AVI MO1 M02 MCM DFM RA1 RB1 RC1 T1T2T3 ACM SG+ SG- RA2 RB2 RC2 SCMS1 MI8

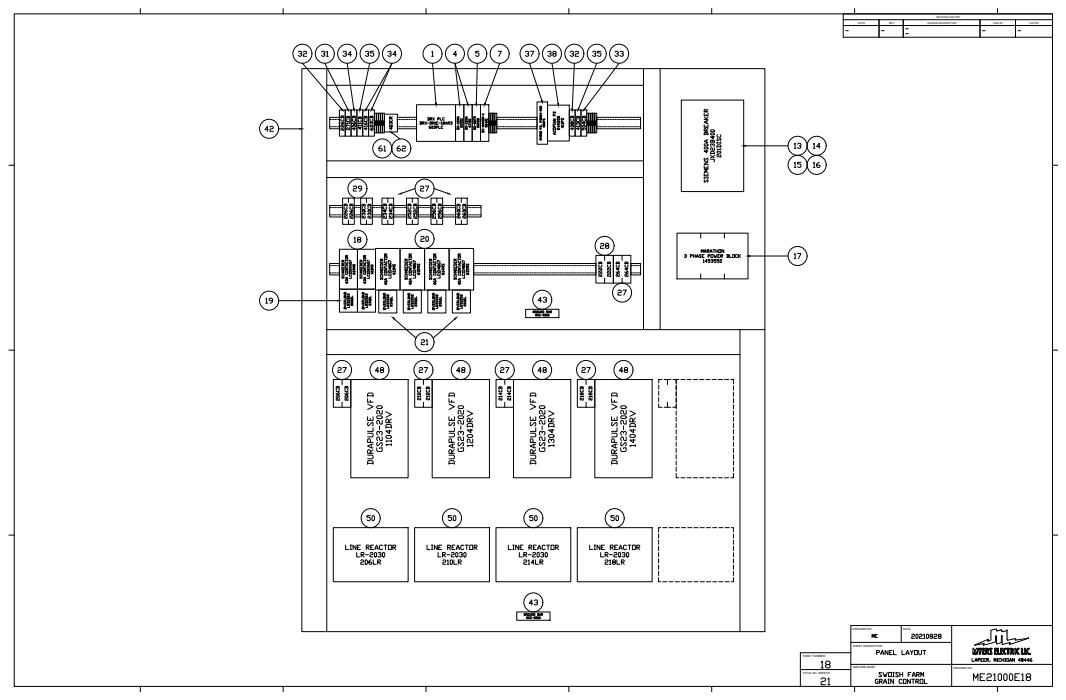
[picture p38: page 13]
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

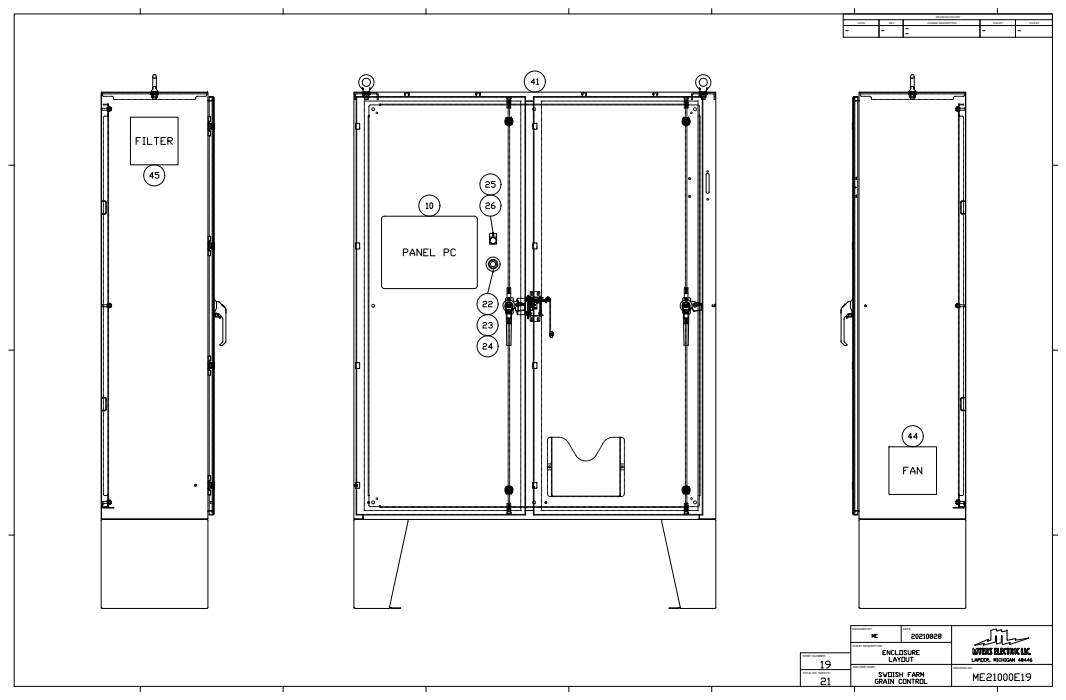
[picture p39: page 14]
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
