gtetil/ME21000-Swoish-Grain-Control/LabVIEW/Layout/Grain Operation Layout.pdf

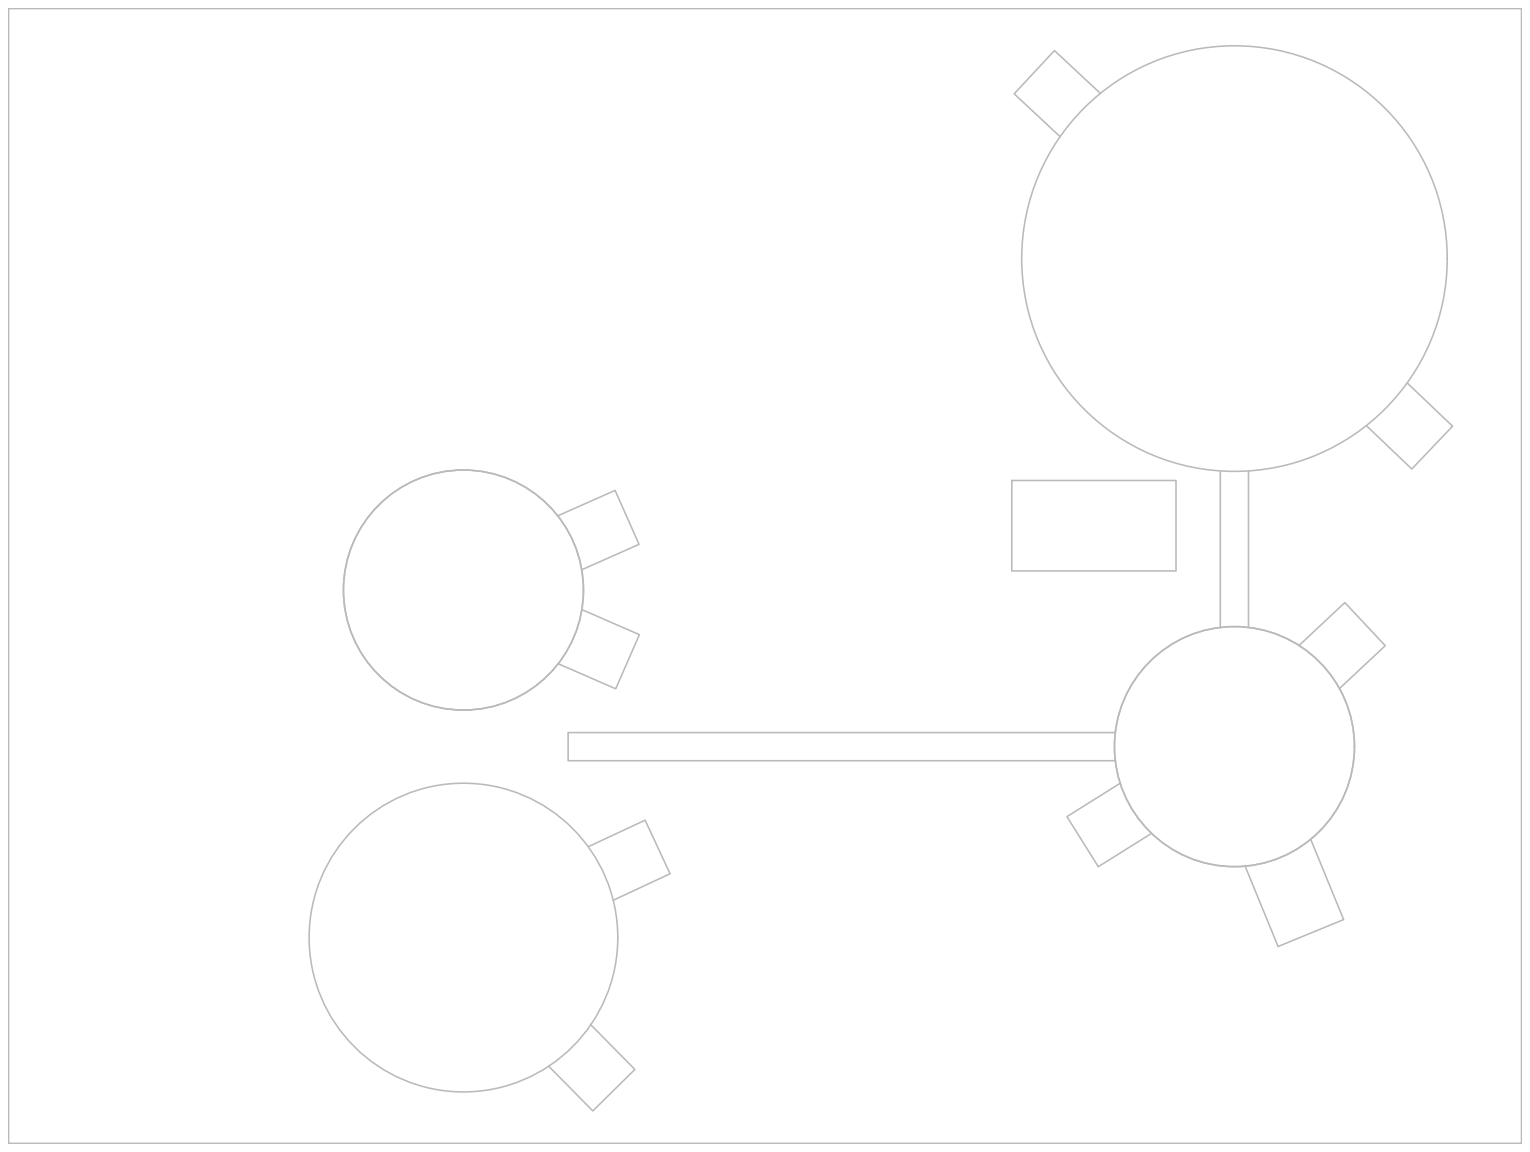
[picture p40: page 1]
