gtetil/ME21000-Swoish-Grain-Control/(commit log)

2021-09-18 Initial commit.
    [ME21000E00.dwg, ME21000E01 (SPARE).dwg, ME21000E02.dwg, ME21000E04.dwg, ME21000E05.dwg, ME21000E06.dwg, ME21000E08.dwg, ME21000E09.dwg]
2021-09-22 LabVIEW initial commit.
    [Grain Operation Layout.dwg]
2021-09-24 Electrical print changes
    - Added Pocket Portal and USB to RS-485 adapter.
    - Added pushbuttons for drag remote control.
    - Changed AI module to 16 bit version.
    [ME21000E05.dwg, ME21000E06.dwg, ME21000E09.dwg]
2021-09-29 Electrical print changes.
    - Removed the RS-485 cable between the Panel PC and the PLC.
    - Added an ethernet cable between the Panel PC and the PLC.
    - Removed the USB-485 adapter.
    - Moved the Pocket Portal to COM 1 on the Panel PC.
    - Added 4 "Off" push buttons for the drags.
    - Added a Vega for Dryer Bin.
    [ME21000E05.dwg, ME21000E06.dwg, ME21000E09.dwg, ME21000E11.dwg]
2021-09-30 Added VFD Toggle functionality.
    [Drive Config.xlsx]
2021-10-01 Initial commit for PLC.
    [Drive Config.xlsx, Swoish Grain Control PLC_EXPORT_CMORE.csv]
2021-10-03 PLC error handling, and started copying VFD PLC code.
    [Swoish Grain Control PLC_EXPORT_CMORE.csv]
2021-10-05 Finish VFD code. Made motor indicator touch larger.
    [Swoish Grain Control PLC_EXPORT_CMORE.csv]
2021-10-05 Added keyboard button to param pop-up
2021-10-05 Added auto mode button.
    [Swoish Grain Control PLC_EXPORT_CMORE.csv]
2021-10-09 Finished Auto Mode.
    [Swoish Grain Control PLC_EXPORT_CMORE.csv]
2021-10-11 Moved DB Fan and Drag Locations.
    [Grain Operation Layout.dwg]
2021-10-20 As left after first day of on-site startup.
    [Drive Config (Dry Bin Drag, Address 3).xlsx, Drive Config (Dry Bin Fan, Address 2).xlsx, Drive Config (Dry Bin Top Feed, Address 4).xlsx, Drive Config (U-Trough, Address 5).xlsx, Drive Config.xlsx, Swoish Grain Control PLC_EXPORT_CMORE.csv]
2021-10-22 As left after day 3.
    [Drive Config (Dry Bin Drag, Address 3).xlsx, Drive Config (Dry Bin Fan, Address 2).xlsx, Drive Config (Dry Bin Top Feed, Address 4).xlsx, Swoish Grain Control PLC_EXPORT_CMORE.csv]
2021-10-24 As left after day 5 of startup.
    [Drive Config (Dry Bin Top Feed, Address 4).xlsx, Swoish Grain Control PLC_EXPORT_CMORE.csv]
2022-05-17 Completed 2021 project.
    [ME21000E18_recover.dwg, Swoish Grain Control PLC.Prt]
2022-05-27 Mostly finished with 2022 updates.
    [ME21000E00.dwg, ME21000E01 (SPARE).dwg, ME21000E02.dwg, ME21000E03.dwg, ME21000E04.dwg, ME21000E05.dwg, ME21000E06.dwg, ME21000E08.dwg]
2022-06-27 Added print detail for quick cleaner.
    [ME21000E00.dwg, ME21000E13.dwg, ME21000E14.dwg, ME21000E18.dwg, ME21000E20.dwg, ME21000E22.dwg, ME21000E23.dwg]
